Nikitosya13/Tesla-Tek-Altium/IDC_Tester_v1/Gerber/IDC_Tester_v1_DRILL.TXT

M48
;Layer_Color=9474304
;FILE_FORMAT=4:4
METRIC,LZ
;TYPE=PLATED
T1F00S00C0.3000
T2F00S00C1.2000
T3F00S00C3.5000
;TYPE=NON_PLATED
T4F00S00C2.8000
%
T01
X00017Y0007475
X0135575Y0015775
X0134775Y0044225
X0131375Y0041475
X012745Y004035
X01263Y00417
X0122225Y00411
X01223Y003875
X01237Y00381
X01182Y00404
X011688Y0041725
X0112275Y004105
X011155Y003915
X01135Y00381
X01073Y0040325
X0105975Y0041725
X0101475Y0041075
X01012Y003945
X01029Y00381
X0096625Y0040375
X0095475Y0041725
X00947Y00158
X009745Y0015775
X0100125
X0102725Y00158
X01053Y0015775
X010805
X01108
X011355
X01163
X011905
X01218
X012455
X01273
X0130075
X0132825
X009195
X0089225Y00159
X00866Y0015775
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
