Nikitosya13/Tesla-Tek-Altium/IDC_Tester_v1/_check/Bill of Materials-IDC_Tester_v1.xlsx

Sheet: Bill of Materials-IDC_Tester_v1
Designator | MountType | Mount | Part Number | Solder_Amount | Pkg | Layer | Cable/Wire | Mating Terminals | Mating Part | Quantity
C1, C2, C3, C4, C5, C6, C7, C8, C9, C10, C11, C12, C13, C14, C27, C32, C33 | SMD | MOUNT | SMD CAP CER 1UF 25V X5R 0603 (CC0603KRX5R8BB105) | 2 | 0603 | Top |  |  |  | 17
C15, C16, C17, C18, C19, C20, C21, C22, C23, C24, C25, C26 | SMD | MOUNT | SMD CAP CER 1UF 25V X5R 0603 (CC0603KRX5R8BB105) | 2 | 0603 | Bottom |  |  |  | 12
C28, C30 | SMD | MOUNT | CAP CER 0603 0.1uF 16V 10% | 2 | 0603 | Top |  |  |  | 2
C29, C31 | SMD | MOUNT | CAP CER 0603 10uF 16V 10% | 2 | 0603 | Top |  |  |  | 2
DD1 | THM | MOUNT | STM32F103C8T6 (blue pill) | 40 | PBS-40 (STM32 blue pill) | Top |  |  |  | 1
DD2, DD3, DD4, DD5, DD6, DD7, DD8, DD9, DD10, DD11, DD12, DD13 | SMD | MOUNT | 74HC595D,118 | 16 | SOIC-16 | Top |  |  |  | 12
DD14, DD15, DD16, DD17, DD18, DD19, DD20, DD21, DD22, DD23, DD24, DD25 | SMD | MOUNT | SN74HC165DR | 16 | 16-SOIC | Bottom |  |  |  | 12
R1, R3, R5, R7, R9, R11, R13, R15, R17, R19, R21, R23, R25, R27, R29, R31, R33, R35, R37, R39, R41, R43, R45, R47, R49, R51, R53, R55, R57, R59, R61, R63, R65, R67, R69, R71, R73, R75, R77, R79, R81, R83, R85, R87, R89, R91, R93, R95, R97, R99, R101, R103, R105, R107, R109, R111, R113, R115, R117, R119, R121, R123, R125, R127, R129, R131, R133, R135, R137, R139, R141, R143, R145, R147, R149, R151, R153, R155, R157, R159, R161, R163, R165, R167, R169, R171, R173, R175, R177, R179, R181, R183, R185, R187, R189, R191, R313, R315, R317, R319, R325, R327 | SMD | MOUNT | SMD RES 1K OHM 1%±100ppm/°C 0603 (RMCF0603FT1K00) | 2 | 0603 | Top |  |  |  | 102
R2, R6, R10, R14, R18, R22, R26, R30, R34, R38, R42, R46, R50, R54, R58, R62, R66, R70, R74, R78, R82, R86, R90, R94, R98, R102, R106, R110, R114, R118, R122, R126, R130, R134, R138, R142, R146, R150, R154, R158, R162, R166, R170, R174, R178, R182, R186, R190 | SMD | MOUNT | SMD RES 10K OHM 1%±100ppm/°C 0603 (RMCF0603FT10K0) | 2 | 0603 | Bottom |  |  |  | 48
R4, R8, R12, R16, R20, R24, R28, R32, R36, R40, R44, R48, R52, R56, R60, R64, R68, R72, R76, R80, R84, R88, R92, R96, R100, R104, R108, R112, R116, R120, R124, R128, R132, R136, R140, R144, R148, R152, R156, R160, R164, R168, R172, R176, R180, R184, R188, R192, R193, R194, R195, R196, R197, R198, R199, R200, R201, R202, R203, R204, R205, R206, R207, R208, R209, R210, R211, R212, R213, R214, R215, R216, R318, R320, R321, R322, R326, R328 | SMD | MOUNT | SMD RES 10K OHM 1%±100ppm/°C 0603 (RMCF0603FT10K0) | 2 | 0603 | Top |  |  |  | 78
R217, R218, R219, R220, R221, R222, R223, R224, R225, R226, R227, R228, R229, R230, R231, R232, R233, R234, R235, R236, R237, R238, R239, R240, R241, R242, R243, R244, R245, R246, R247, R248, R249, R250, R251, R252, R253, R254, R255, R256, R257, R258, R259, R260, R261, R262, R263, R264, R265, R266, R267, R268, R269, R270, R271, R272, R273, R274, R275, R276, R277, R278, R279, R280, R281, R282, R283, R284, R285, R286, R287, R288, R289, R290, R291, R292, R293, R294, R295, R296, R297, R298, R299, R300, R301, R302, R303, R304, R305, R306, R307, R308, R309, R310, R311, R312 | SMD | MOUNT | SMD RES 100 OHM 1% ±100ppm/°C 0603 (RMCF0603FT100R) | 2 | 0603 | Top |  |  |  | 96
R323, R324 | SMD | DNP | SMD RES 10 OHM 1% ±100ppm/°C 0603 (RMCF0603FT10R) | 2 | 0603 | Top |  |  |  | 2
S1, S2, S3, S4 | SMD | MOUNT | PTS645SM43SMTR92LFS | 4 | Button | Top |  |  |  | 4
U1 | SMD | MOUNT | LM1117DT-3.3/NOPB | 3 | TD03B_N | Top |  |  |  | 1
VD1, VD2, VD3, VD4, VD5, VD6, VD7, VD8, VD9, VD10, VD11, VD12, VD13, VD14, VD15, VD16, VD17, VD18, VD19, VD20, VD21, VD22, VD23, VD24, VD25, VD26, VD27, VD28, VD29, VD30, VD31, VD32, VD33, VD34, VD35, VD36, VD37, VD38, VD39, VD40, VD41, VD42, VD43, VD44, VD45, VD46, VD47, VD48, VD49, VD50, VD51, VD52, VD53, VD54, VD55, VD56, VD57, VD58, VD59, VD60, VD61, VD62, VD63, VD64, VD65, VD66, VD67, VD68, VD69, VD70, VD71, VD72, VD73, VD74, VD75, VD76, VD77, VD78, VD79, VD80, VD81, VD82, VD83, VD84, VD85, VD86, VD87, VD88, VD89, VD90, VD91, VD92, VD93, VD94, VD95, VD96, VD97 | SMD | MOUNT | APG1608ZGCK | 2 | 0603 | Top |  |  |  | 97
VD98 | SMD | MOUNT | APT1608SURCK | 2 | 0603 | Top |  |  |  | 1
VT1, VT3, VT5, VT7, VT9, VT11, VT13, VT15, VT17, VT19, VT21, VT23, VT25, VT27, VT29, VT31, VT33, VT35, VT37, VT39, VT41, VT43, VT45, VT47, VT49, VT51, VT53, VT55, VT57, VT59, VT61, VT63, VT65, VT67, VT69, VT71, VT73, VT75, VT77, VT79, VT81, VT83, VT85, VT87, VT89, VT91, VT93, VT95 | SMD | MOUNT | BSS138 | 3 | SOT-23 | Bottom |  |  |  | 48
VT2, VT4, VT6, VT8, VT10, VT12, VT14, VT16, VT18, VT20, VT22, VT24, VT26, VT28, VT30, VT32, VT34, VT36, VT38, VT40, VT42, VT44, VT46, VT48, VT50, VT52, VT54, VT56, VT58, VT60, VT62, VT64, VT66, VT68, VT70, VT72, VT74, VT76, VT78, VT80, VT82, VT84, VT86, VT88, VT90, VT92, VT94, VT96 | SMD | MOUNT | BSS138 | 3 | SOT-23 | Top |  |  |  | 48
X1, X2, X4, X5 | THM | MOUNT | DS1021-2x20 | 40 | PLD-40 | Top |  |  |  | 4
X3, X6 | THM | MOUNT | DS1021-2x8 | 16 | PLD-16 | Top |  |  |  | 2
X7 | THM | MOUNT | LCD1602I2C (green light) | 4 | board (connector) | Top |  |  |  | 1

Sheet: Перечень_элементов
Позиционное обозначение | Наименование | Корпус | Кол-во
Резисторы
R1, R3, R5, R7, R9, R11, R13, R15, R17, R19, R21, R23, R25, R27, R29, R31, R33, R35, R37, R39, R41, R43, R45, R47, R49, R51, R53, R55, R57, R59, R61, R63, R65, R67, R69, R71, R73, R75, R77, R79, R81, R83, R85, R87, R89, R91, R93, R95, R97, R99, R101, R103, R105, R107, R109, R111, R113, R115, R117, R119, R121, R123, R125, R127, R129, R131, R133, R135, R137, R139, R141, R143, R145, R147, R149, R151, R153, R155, R157, R159, R161, R163, R165, R167, R169, R171, R173, R175, R177, R179, R181, R183, R185, R187, R189, R191, R313, R315, R317, R319, R325, R327 | SMD RES 1K OHM 1%±100ppm/°C 0603 (RMCF0603FT1K00) | 0603 | 102
R2, R6, R10, R14, R18, R22, R26, R30, R34, R38, R42, R46, R50, R54, R58, R62, R66, R70, R74, R78, R82, R86, R90, R94, R98, R102, R106, R110, R114, R118, R122, R126, R130, R134, R138, R142, R146, R150, R154, R158, R162, R166, R170, R174, R178, R182, R186, R190, R4, R8, R12, R16, R20, R24, R28, R32, R36, R40, R44, R48, R52, R56, R60, R64, R68, R72, R76, R80, R84, R88, R92, R96, R100, R104, R108, R112, R116, R120, R124, R128, R132, R136, R140, R144, R148, R152, R156, R160, R164, R168, R172, R176, R180, R184, R188, R192, R193, R194, R195, R196, R197, R198, R199, R200, R201, R202, R203, R204, R205, R206, R207, R208, R209, R210, R211, R212, R213, R214, R215, R216, R318, R320, R321, R322, R326, R328 | SMD RES 10K OHM 1%±100ppm/°C 0603 (RMCF0603FT10K0) | 0603 | 126
R217, R218, R219, R220, R221, R222, R223, R224, R225, R226, R227, R228, R229, R230, R231, R232, R233, R234, R235, R236, R237, R238, R239, R240, R241, R242, R243, R244, R245, R246, R247, R248, R249, R250, R251, R252, R253, R254, R255, R256, R257, R258, R259, R260, R261, R262, R263, R264, R265, R266, R267, R268, R269, R270, R271, R272, R273, R274, R275, R276, R277, R278, R279, R280, R281, R282, R283, R284, R285, R286, R287, R288, R289, R290, R291, R292, R293, R294, R295, R296, R297, R298, R299, R300, R301, R302, R303, R304, R305, R306, R307, R308, R309, R310, R311, R312 | SMD RES 100 OHM 1% ±100ppm/°C 0603 (RMCF0603FT100R) | 0603 | 96
R323, R324 | SMD RES 10 OHM 1% ±100ppm/°C 0603 (RMCF0603FT10R) | 0603 | 2
Конденсаторы
C1, C2, C3, C4, C5, C6, C7, C8, C9, C10, C11, C12, C13, C14, C27, C32, C33, C15, C16, C17, C18, C19, C20, C21, C22, C23, C24, C25, C26 | SMD CAP CER 1UF 25V X5R 0603 (CC0603KRX5R8BB105) | 0603 | 29
C28, C30 | CAP CER 0603 0.1uF 16V 10% | 0603 | 2
C29, C31 | CAP CER 0603 10uF 16V 10% | 0603 | 2
Диоды / Транзисторы
VD1, VD2, VD3, VD4, VD5, VD6, VD7, VD8, VD9, VD10, VD11, VD12, VD13, VD14, VD15, VD16, VD17, VD18, VD19, VD20, VD21, VD22, VD23, VD24, VD25, VD26, VD27, VD28, VD29, VD30, VD31, VD32, VD33, VD34, VD35, VD36, VD37, VD38, VD39, VD40, VD41, VD42, VD43, VD44, VD45, VD46, VD47, VD48, VD49, VD50, VD51, VD52, VD53, VD54, VD55, VD56, VD57, VD58, VD59, VD60, VD61, VD62, VD63, VD64, VD65, VD66, VD67, VD68, VD69, VD70, VD71, VD72, VD73, VD74, VD75, VD76, VD77, VD78, VD79, VD80, VD81, VD82, VD83, VD84, VD85, VD86, VD87, VD88, VD89, VD90, VD91, VD92, VD93, VD94, VD95, VD96, VD97 | APG1608ZGCK | 0603 | 97
VD98 | APT1608SURCK | 0603 | 1
VT1, VT3, VT5, VT7, VT9, VT11, VT13, VT15, VT17, VT19, VT21, VT23, VT25, VT27, VT29, VT31, VT33, VT35, VT37, VT39, VT41, VT43, VT45, VT47, VT49, VT51, VT53, VT55, VT57, VT59, VT61, VT63, VT65, VT67, VT69, VT71, VT73, VT75, VT77, VT79, VT81, VT83, VT85, VT87, VT89, VT91, VT93, VT95, VT2, VT4, VT6, VT8, VT10, VT12, VT14, VT16, VT18, VT20, VT22, VT24, VT26, VT28, VT30, VT32, VT34, VT36, VT38, VT40, VT42, VT44, VT46, VT48, VT50, VT52, VT54, VT56, VT58, VT60, VT62, VT64, VT66, VT68, VT70, VT72, VT74, VT76, VT78, VT80, VT82, VT84, VT86, VT88, VT90, VT92, VT94, VT96 | BSS138 | SOT-23 | 96
Микросхемы
DD1 | STM32F103C8T6 (blue pill) | PBS-40 (STM32 blue pill) | 1
DD2, DD3, DD4, DD5, DD6, DD7, DD8, DD9, DD10, DD11, DD12, DD13 | 74HC595D,118 | SOIC-16 | 12
DD14, DD15, DD16, DD17, DD18, DD19, DD20, DD21, DD22, DD23, DD24, DD25 | SN74HC165DR | 16-SOIC | 12
U1 | LM1117DT-3.3/NOPB | TD03B_N | 1
Переключатели/кнопки/ключи
S1, S2, S3, S4 | PTS645SM43SMTR92LFS | Button | 4
Разъемы
X1, X2, X4, X5 | DS1021-2x20 | PLD-40 | 4
X3, X6 | DS1021-2x8 | PLD-16 | 2
X7 | LCD1602I2C (green light) | board (connector) | 1

Sheet: Монтажная_Спецификация
Перечень монтируемых элементов Bill of Materials-IDC_Tester_v1
Позиционное обозначение | Наименование | Корпус | Кол-во | Кол-во паек / поз. | Общее кол-во паек | Тип монтажа
Сторона TOP
C1, C2, C3, C4, C5, C6, C7, C8, C9, C10, C11, C12, C13, C14, C27, C32, C33 | SMD CAP CER 1UF 25V X5R 0603 (CC0603KRX5R8BB105) | 0603 | 17 | 2 | 34 | SMD
C28, C30 | CAP CER 0603 0.1uF 16V 10% | 0603 | 2 | 2 | 4 | SMD
C29, C31 | CAP CER 0603 10uF 16V 10% | 0603 | 2 | 2 | 4 | SMD
DD2, DD3, DD4, DD5, DD6, DD7, DD8, DD9, DD10, DD11, DD12, DD13 | 74HC595D,118 | SOIC-16 | 12 | 16 | 192 | SMD
R1, R3, R5, R7, R9, R11, R13, R15, R17, R19, R21, R23, R25, R27, R29, R31, R33, R35, R37, R39, R41, R43, R45, R47, R49, R51, R53, R55, R57, R59, R61, R63, R65, R67, R69, R71, R73, R75, R77, R79, R81, R83, R85, R87, R89, R91, R93, R95, R97, R99, R101, R103, R105, R107, R109, R111, R113, R115, R117, R119, R121, R123, R125, R127, R129, R131, R133, R135, R137, R139, R141, R143, R145, R147, R149, R151, R153, R155, R157, R159, R161, R163, R165, R167, R169, R171, R173, R175, R177, R179, R181, R183, R185, R187, R189, R191, R313, R315, R317, R319, R325, R327 | SMD RES 1K OHM 1%±100ppm/°C 0603 (RMCF0603FT1K00) | 0603 | 102 | 2 | 204 | SMD
R217, R218, R219, R220, R221, R222, R223, R224, R225, R226, R227, R228, R229, R230, R231, R232, R233, R234, R235, R236, R237, R238, R239, R240, R241, R242, R243, R244, R245, R246, R247, R248, R249, R250, R251, R252, R253, R254, R255, R256, R257, R258, R259, R260, R261, R262, R263, R264, R265, R266, R267, R268, R269, R270, R271, R272, R273, R274, R275, R276, R277, R278, R279, R280, R281, R282, R283, R284, R285, R286, R287, R288, R289, R290, R291, R292, R293, R294, R295, R296, R297, R298, R299, R300, R301, R302, R303, R304, R305, R306, R307, R308, R309, R310, R311, R312 | SMD RES 100 OHM 1% ±100ppm/°C 0603 (RMCF0603FT100R) | 0603 | 96 | 2 | 192 | SMD
R4, R8, R12, R16, R20, R24, R28, R32, R36, R40, R44, R48, R52, R56, R60, R64, R68, R72, R76, R80, R84, R88, R92, R96, R100, R104, R108, R112, R116, R120, R124, R128, R132, R136, R140, R144, R148, R152, R156, R160, R164, R168, R172, R176, R180, R184, R188, R192, R193, R194, R195, R196, R197, R198, R199, R200, R201, R202, R203, R204, R205, R206, R207, R208, R209, R210, R211, R212, R213, R214, R215, R216, R318, R320, R321, R322, R326, R328 | SMD RES 10K OHM 1%±100ppm/°C 0603 (RMCF0603FT10K0) | 0603 | 78 | 2 | 156 | SMD
S1, S2, S3, S4 | PTS645SM43SMTR92LFS | Button | 4 | 4 | 16 | SMD
U1 | LM1117DT-3.3/NOPB | TD03B_N | 1 | 3 | 3 | SMD
VD1, VD2, VD3, VD4, VD5, VD6, VD7, VD8, VD9, VD10, VD11, VD12, VD13, VD14, VD15, VD16, VD17, VD18, VD19, VD20, VD21, VD22, VD23, VD24, VD25, VD26, VD27, VD28, VD29, VD30, VD31, VD32, VD33, VD34, VD35, VD36, VD37, VD38, VD39, VD40, VD41, VD42, VD43, VD44, VD45, VD46, VD47, VD48, VD49, VD50, VD51, VD52, VD53, VD54, VD55, VD56, VD57, VD58, VD59, VD60, VD61, VD62, VD63, VD64, VD65, VD66, VD67, VD68, VD69, VD70, VD71, VD72, VD73, VD74, VD75, VD76, VD77, VD78, VD79, VD80, VD81, VD82, VD83, VD84, VD85, VD86, VD87, VD88, VD89, VD90, VD91, VD92, VD93, VD94, VD95, VD96, VD97 | APG1608ZGCK | 0603 | 97 | 2 | 194 | SMD
VD98 | APT1608SURCK | 0603 | 1 | 2 | 2 | SMD
VT2, VT4, VT6, VT8, VT10, VT12, VT14, VT16, VT18, VT20, VT22, VT24, VT26, VT28, VT30, VT32, VT34, VT36, VT38, VT40, VT42, VT44, VT46, VT48, VT50, VT52, VT54, VT56, VT58, VT60, VT62, VT64, VT66, VT68, VT70, VT72, VT74, VT76, VT78, VT80, VT82, VT84, VT86, VT88, VT90, VT92, VT94, VT96 | BSS138 | SOT-23 | 48 | 3 | 144 | SMD
DD1 | STM32F103C8T6 (blue pill) | PBS-40 (STM32 blue pill) | 1 | 40 | 40 | THM
X1, X2, X4, X5 | DS1021-2x20 | PLD-40 | 4 | 40 | 160 | THM
X3, X6 | DS1021-2x8 | PLD-16 | 2 | 16 | 32 | THM
X7 | LCD1602I2C (green light) | board (connector) | 1 | 4 | 4 | THM
Сторона BOT
C15, C16, C17, C18, C19, C20, C21, C22, C23, C24, C25, C26 | SMD CAP CER 1UF 25V X5R 0603 (CC0603KRX5R8BB105) | 0603 | 12 | 2 | 24 | SMD
DD14, DD15, DD16, DD17, DD18, DD19, DD20, DD21, DD22, DD23, DD24, DD25 | SN74HC165DR | 16-SOIC | 12 | 16 | 192 | SMD
R2, R6, R10, R14, R18, R22, R26, R30, R34, R38, R42, R46, R50, R54, R58, R62, R66, R70, R74, R78, R82, R86, R90, R94, R98, R102, R106, R110, R114, R118, R122, R126, R130, R134, R138, R142, R146, R150, R154, R158, R162, R166, R170, R174, R178, R182, R186, R190 | SMD RES 10K OHM 1%±100ppm/°C 0603 (RMCF0603FT10K0) | 0603 | 48 | 2 | 96 | SMD
VT1, VT3, VT5, VT7, VT9, VT11, VT13, VT15, VT17, VT19, VT21, VT23, VT25, VT27, VT29, VT31, VT33, VT35, VT37, VT39, VT41, VT43, VT45, VT47, VT49, VT51, VT53, VT55, VT57, VT59, VT61, VT63, VT65, VT67, VT69, VT71, VT73, VT75, VT77, VT79, VT81, VT83, VT85, VT87, VT89, VT91, VT93, VT95 | BSS138 | SOT-23 | 48 | 3 | 144 | SMD
Количество паек на устройство
Сторона TOP
Количество паек SMD |  |  |  |  |  | 1145
Количество паек THM |  |  |  |  |  | 236
Общее количество паек на стороне TOP |  |  |  |  |  | 1381
Количество компонентов SMD |  |  |  |  |  | 460
Количество компонентов THM |  |  |  |  |  | 8
Общее количество компонентов на стороне TOP |  |  |  |  |  | 468
Сторона BOT
Количество паек SMD |  |  |  |  |  | 456
Количество паек THM |  |  |  |  |  | 0
Общее количество паек на стороне BOT |  |  |  |  |  | 456
Количество компонентов SMD |  |  |  |  |  | 120
Количество компонентов THM |  |  |  |  |  | 0
Общее количество компонентов на стороне BOT |  |  |  |  |  | 120
Итог
Всего паек SMD |  |  |  |  |  | 1601
Всего паек THM |  |  |  |  |  | 236
Всего компонентов SMD |  |  |  |  |  | 580
Всего компонентов THM |  |  |  |  |  | 8
Перечень немонтируемых элементов Bill of Materials-IDC_Tester_v1
Позиционное обозначение | Наименование | Корпус | Кол-во | Кол-во паек / поз. | Общее кол-во паек | Тип монтажа
Сторона TOP
R323, R324 | SMD RES 10 OHM 1% ±100ppm/°C 0603 (RMCF0603FT10R) | 0603 | 2 | 2 | 4 | SMD
Сторона BOT

Sheet: К_заказу
Наименование | Корпус | Кол-во общее | Кол-во DNP
74HC595D,118 | SOIC-16 | 12
APG1608ZGCK | 0603 | 97
APT1608SURCK | 0603 | 1
BSS138 | SOT-23 | 96
CAP CER 0603 0.1uF 16V 10% | 0603 | 2
CAP CER 0603 10uF 16V 10% | 0603 | 2
DS1021-2x20 | PLD-40 | 4
DS1021-2x8 | PLD-16 | 2
LCD1602I2C (green light) | board (connector) | 1
LM1117DT-3.3/NOPB | TD03B_N | 1
PTS645SM43SMTR92LFS | Button | 4
SMD CAP CER 1UF 25V X5R 0603 (CC0603KRX5R8BB105) | 0603 | 29
SMD RES 10 OHM 1% ±100ppm/°C 0603 (RMCF0603FT10R) | 0603 | 2 | 2
SMD RES 100 OHM 1% ±100ppm/°C 0603 (RMCF0603FT100R) | 0603 | 96
SMD RES 10K OHM 1%±100ppm/°C 0603 (RMCF0603FT10K0) | 0603 | 126
SMD RES 1K OHM 1%±100ppm/°C 0603 (RMCF0603FT1K00) | 0603 | 102
SN74HC165DR | 16-SOIC | 12
STM32F103C8T6 (blue pill) | PBS-40 (STM32 blue pill) | 1
