Nikitosya13/Tesla-Tek-Altium/IDC_Tester_v1/_3d/IDC_Tester_v1.step

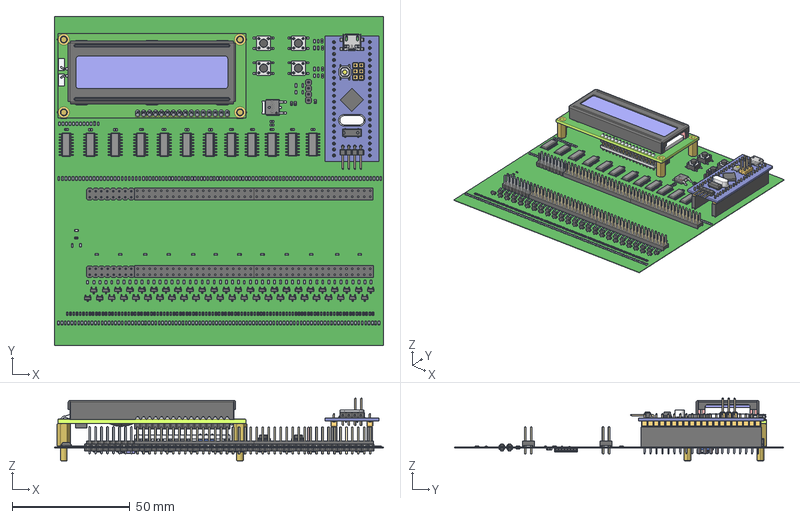
[picture p1: CAD file, 2024-02-29]
IDC_Tester_v1/_3d/IDC_Tester_v1.step
140.0 x 140.0 x 26.8 mm
crg0603f10r x 326
YAG_CC0603_YAG x 33
User_Library-TO-252-3
pcbboard
16pin_header__
lcd_window
backlight
conductor x 2
liquid_crystal_grabcad_i2s
smt_resistor222 x 10
smt_resistor101 x 2
i2C_board
jumper__
pcf8574p
bent_header x 6
led
ssot3
trimpot_3662
smt_cap
M3_M_TO_F_10MM_STANDOFF x 4
PLS-1 x 8
User_Library-PLD-16 x 2
User_Library-PLD-40 x 4
SOT-23-3 x 96
APG1608
LED_0603_Base_GREEN x 97
BODY-SO x 24
LEAD-SO x 384
PIN1-ID x 24
User_Library-PBS_(DS1023)_1line_connectors_h=5_0_8_5mm_step_2_54mm-1 x 2
Oscillator_HC-49/S_v1
STM32F103C8T6_BluePill_Board_v6
Oscillator_MC-306_v3
STM32_LQFP48_v3
Tactile_SMD_5x5mm_v1
micro_usb_socket_v1
Header_L4_10x4.8_v6
Header_Male_2x3x11.6_v2
Header_Male_1x20x11.6_v2 x 2
