Nikitosya13/Tesla-Tek-Altium/IDC_Tester_v1/_docs/IDC_Tester_v1_SCHEMATIC.PDF

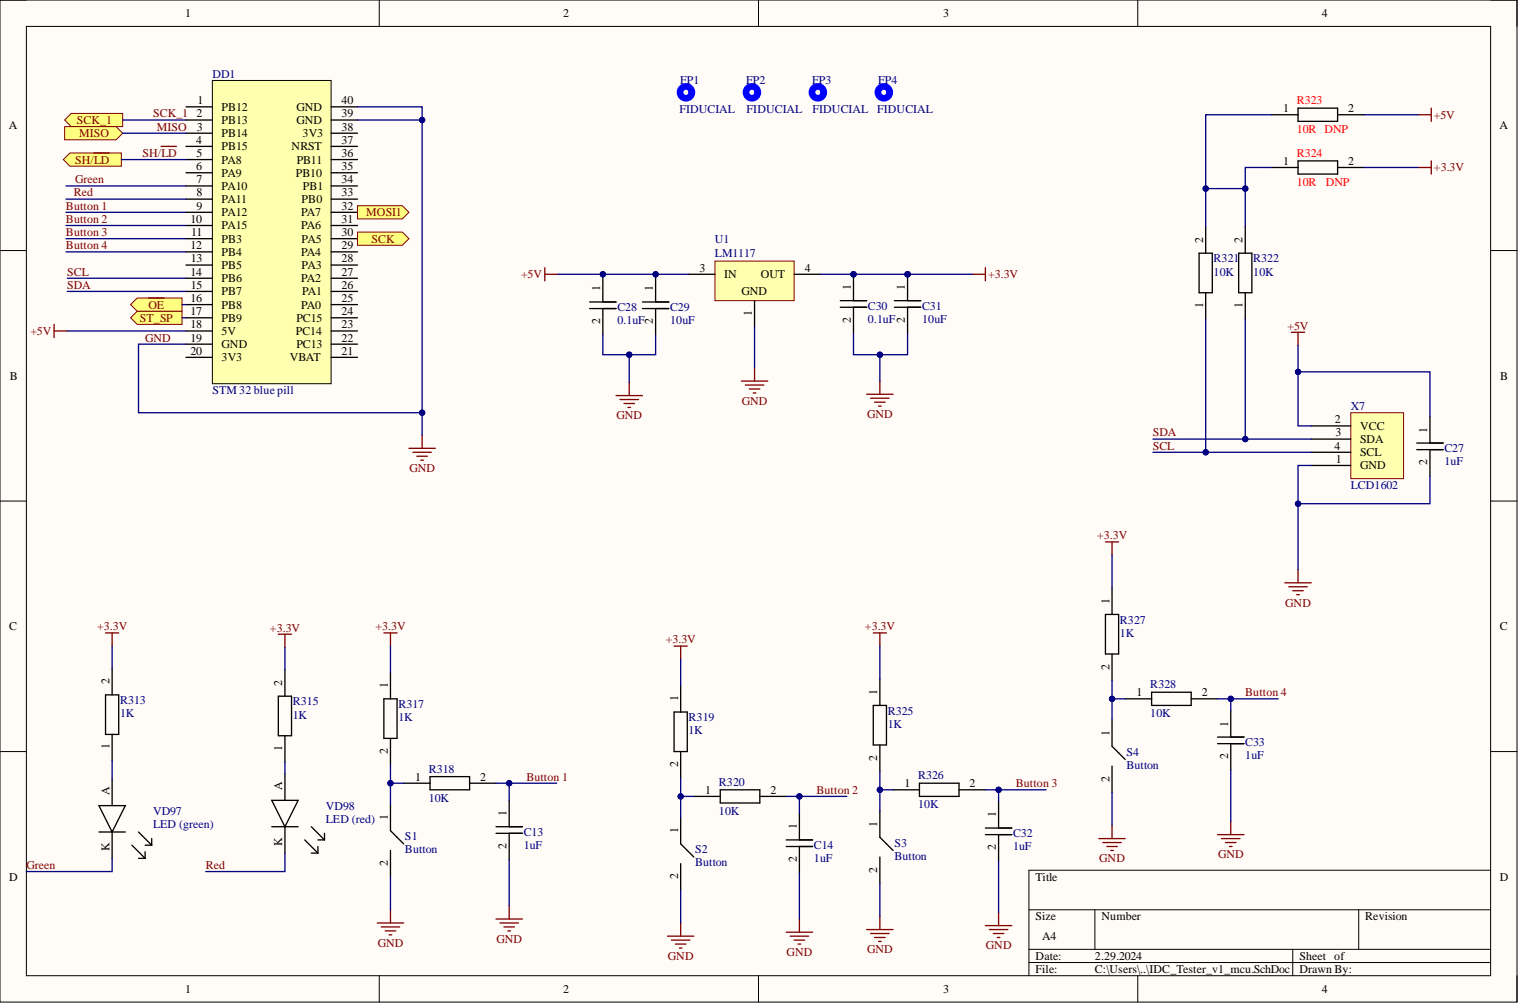
[picture p2: page 1]

X7
VCC 2

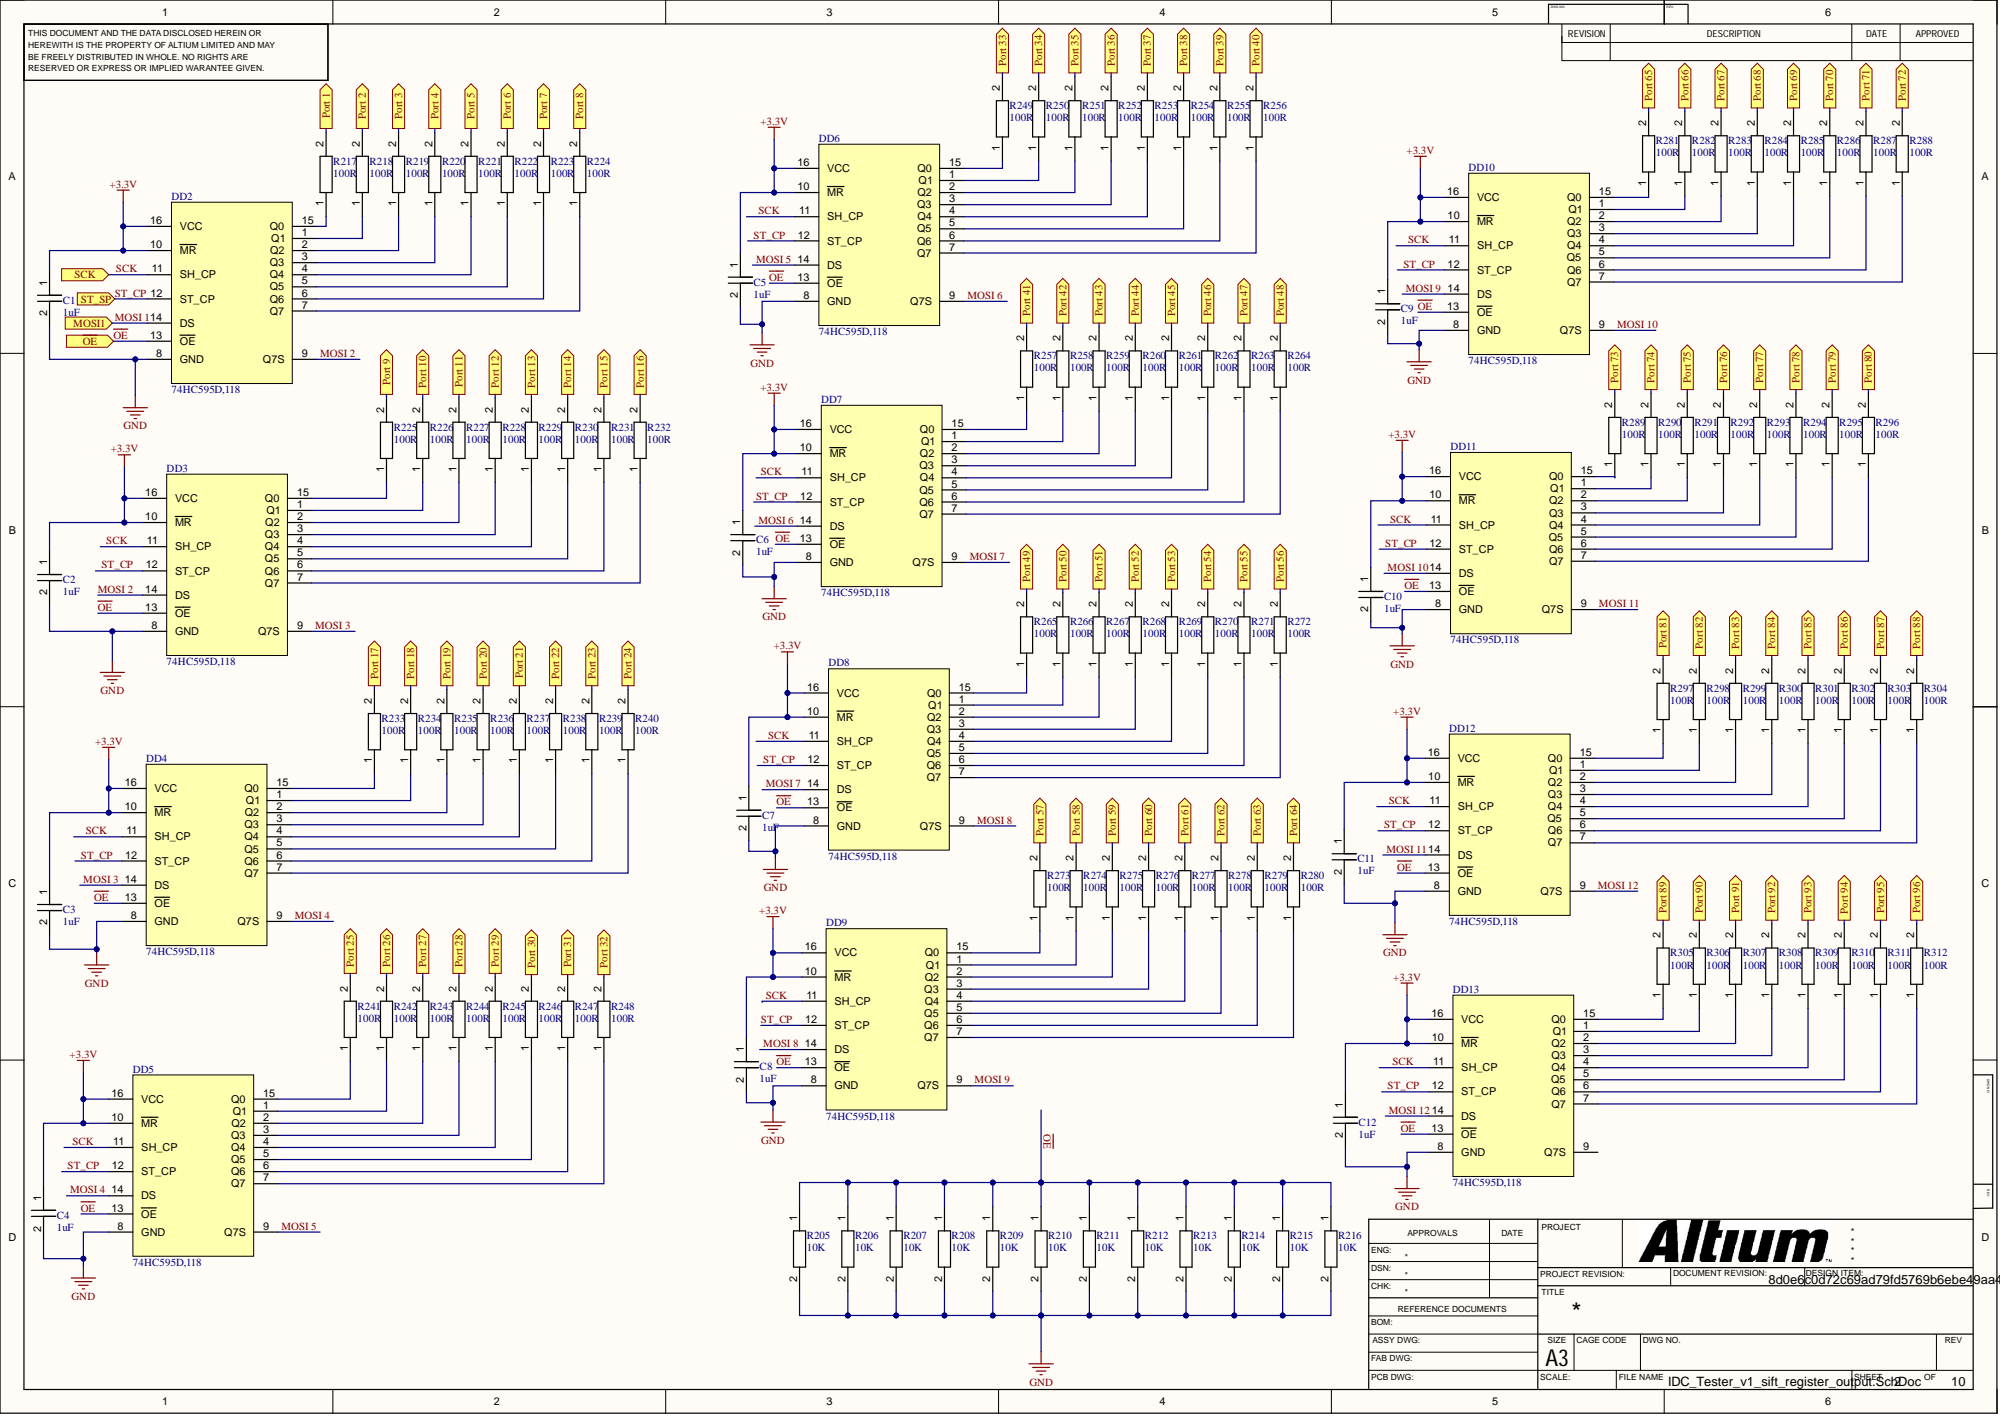
[picture p3: page 2]

DWG NO: | REV:

THIS DOCUMENT AND THE DATA DISCLOSED HEREIN OR HEREWITH IS THE PROPERTY OF ALTIUM LIMITED AND MAY BE FREELY DISTRIBUTED IN WHOLE. NO RIGHTS ARE RESERVED OR EXPRESS OR IMPLIED WARANTEE GIVEN. | | REVISION | DESCRIPTION | DATE | APPROVED

DATE | PROJECT | * * APPROVALS * *

ENG: *

DSN: *

CHK:

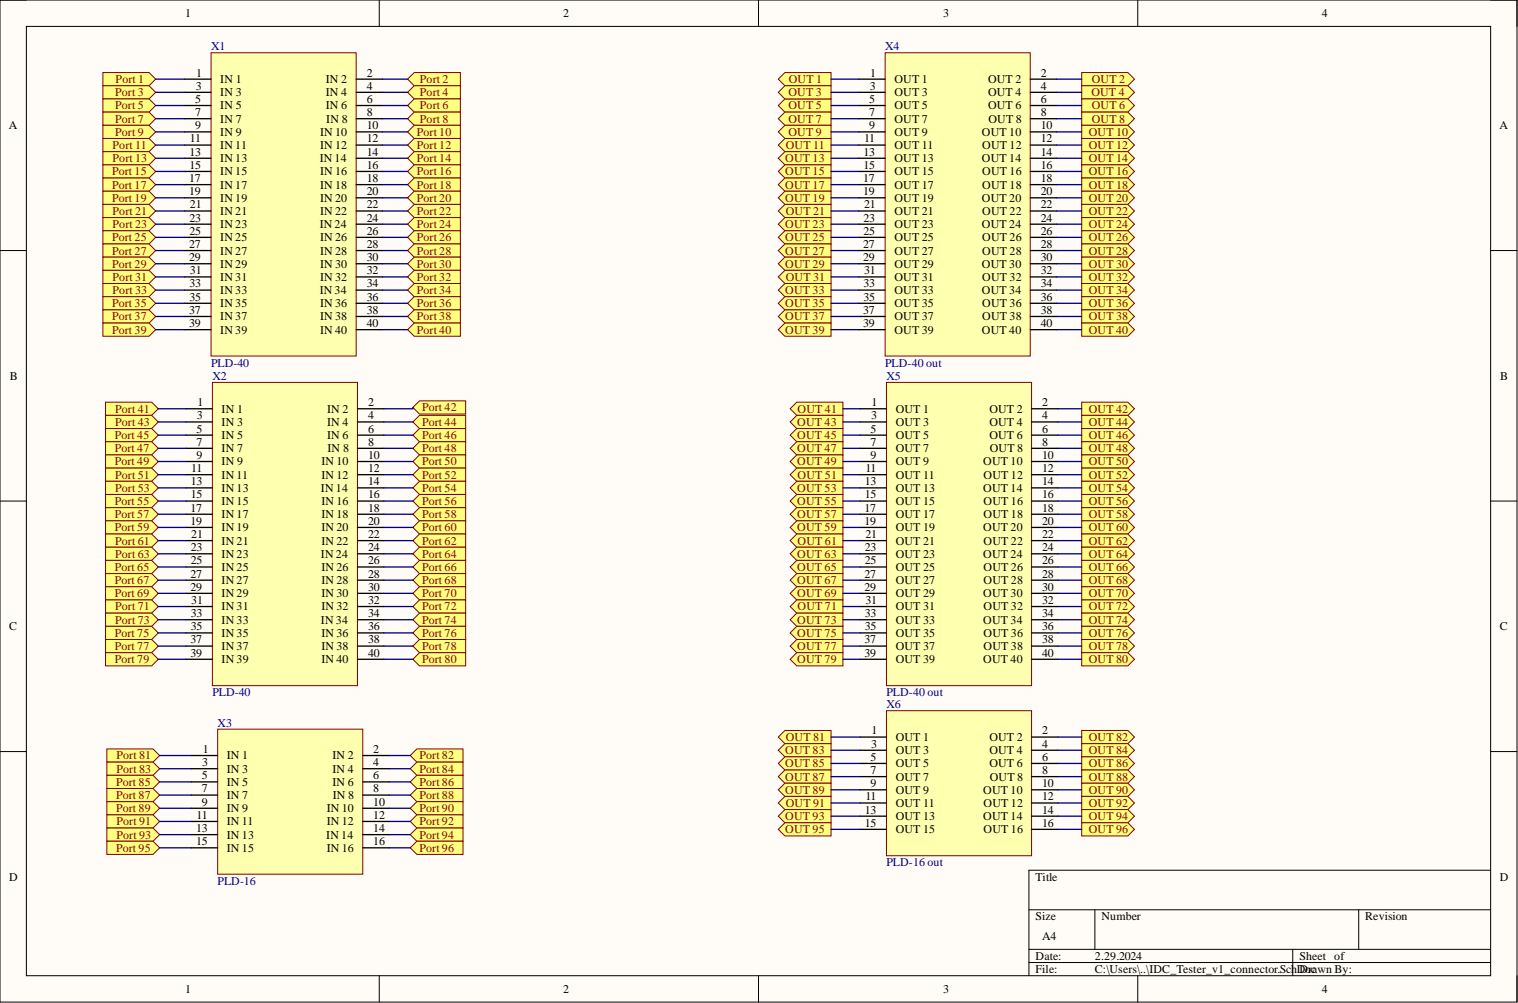
[picture p4: page 3]

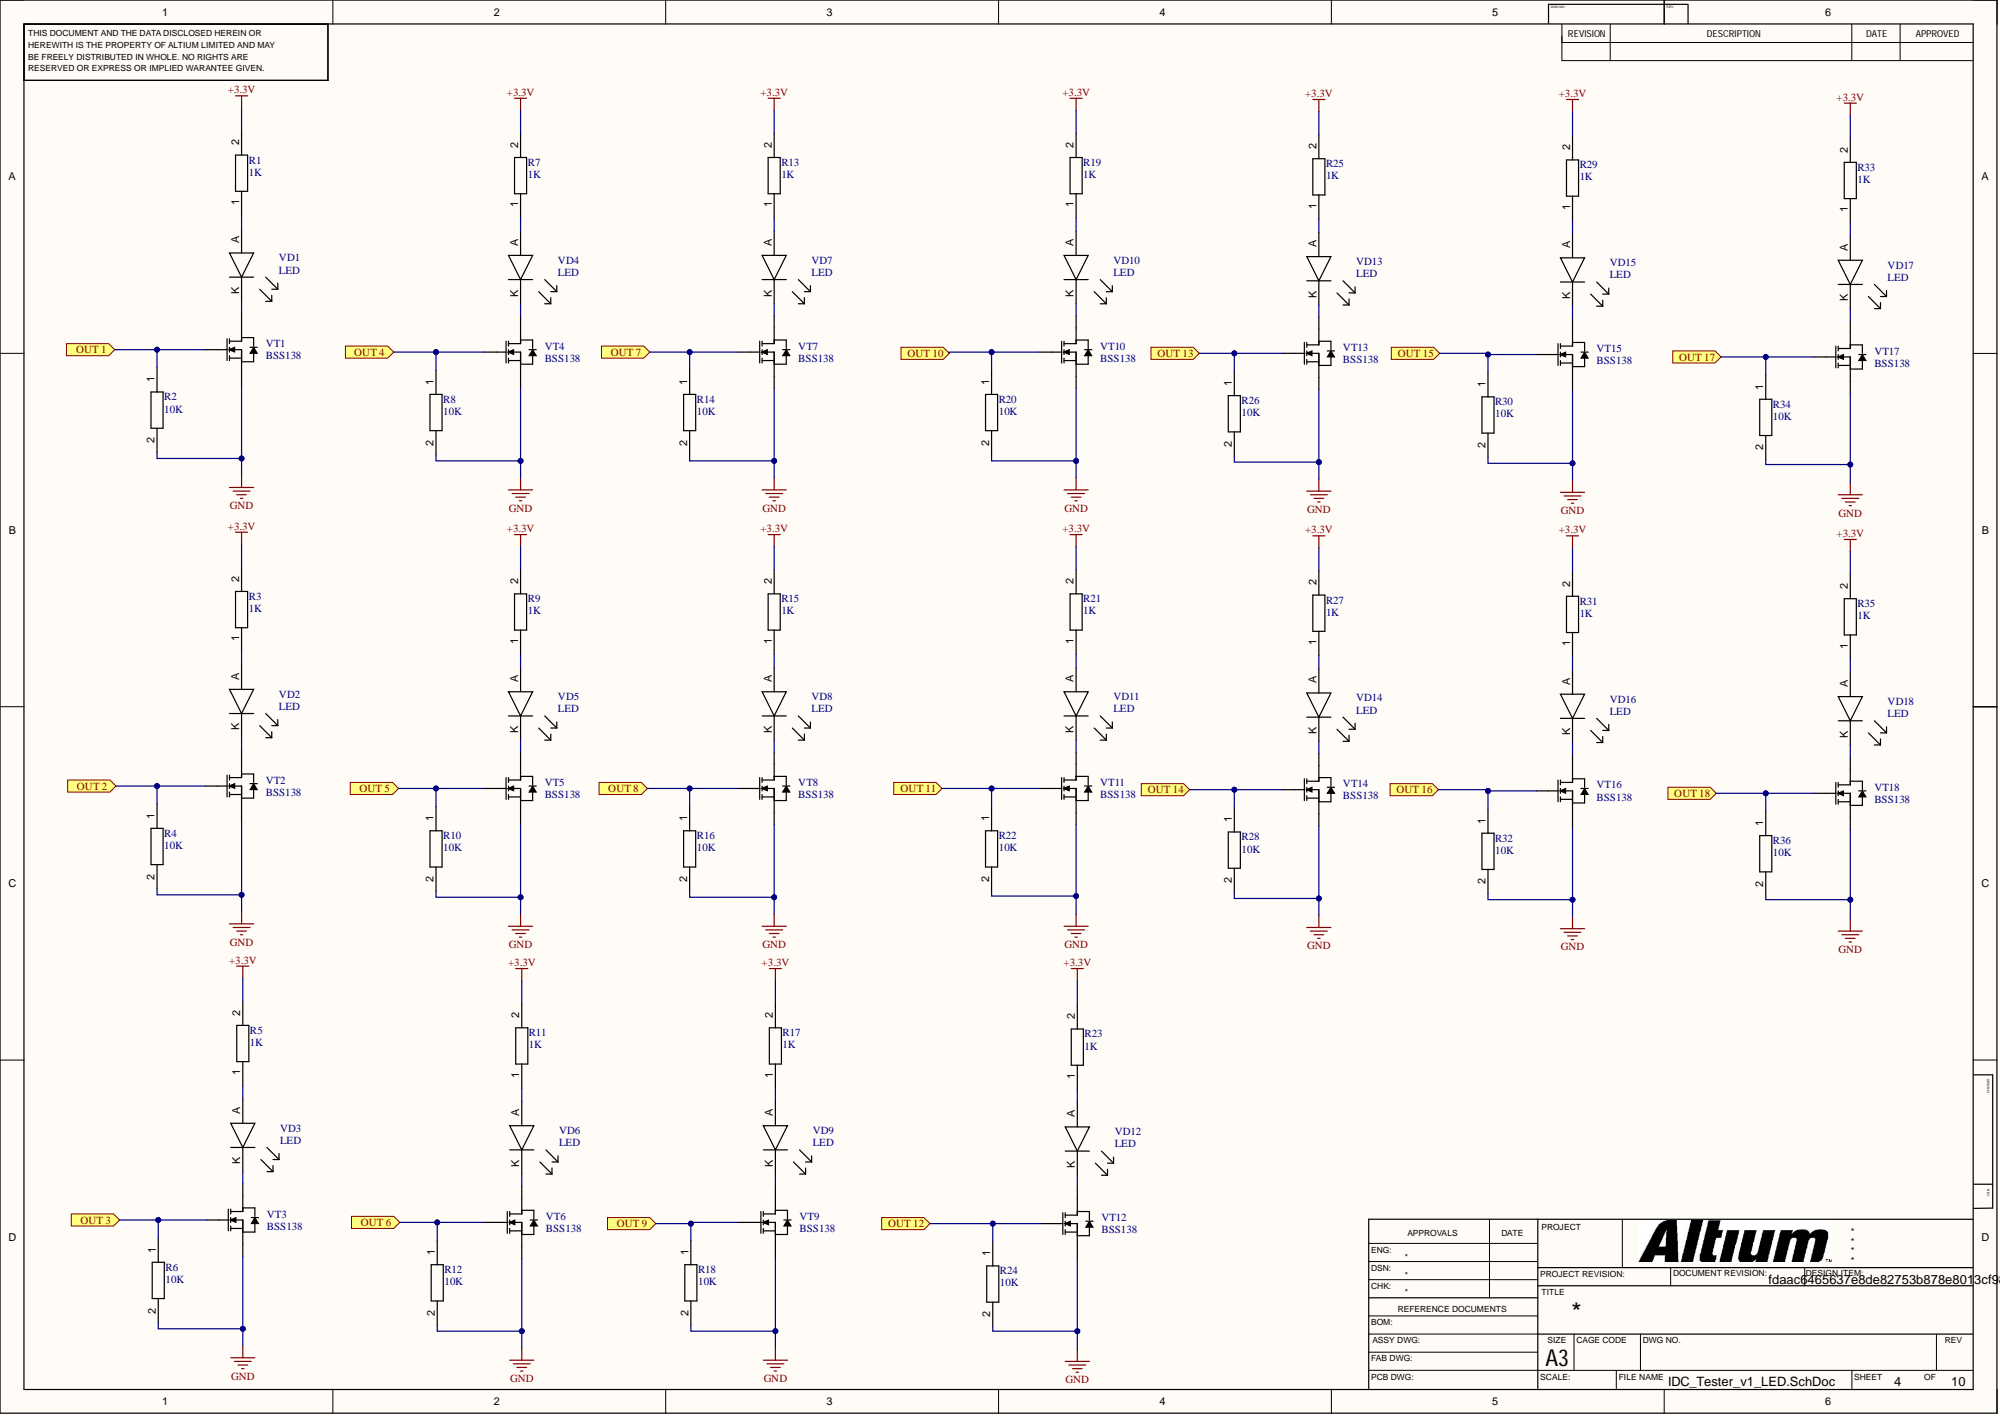
[picture p5: page 4]

THIS DOCUMENT AND THE DA TA DISCL OSED HEREIN O R HEREWITH IS THE PROPERTY OF ALTIUM LIMITED AND M AY BE FREELY DISTRIBUTED IN WHO LE. NO RIGHTS ARE | +3.3 V +3.3 V +3.3 V | REVISI ON | DESCRIPTI O N | DATE | APPROVED

DATE | PRO JECT | **** APPROVALS

ENG :
** DSN:

CHK:

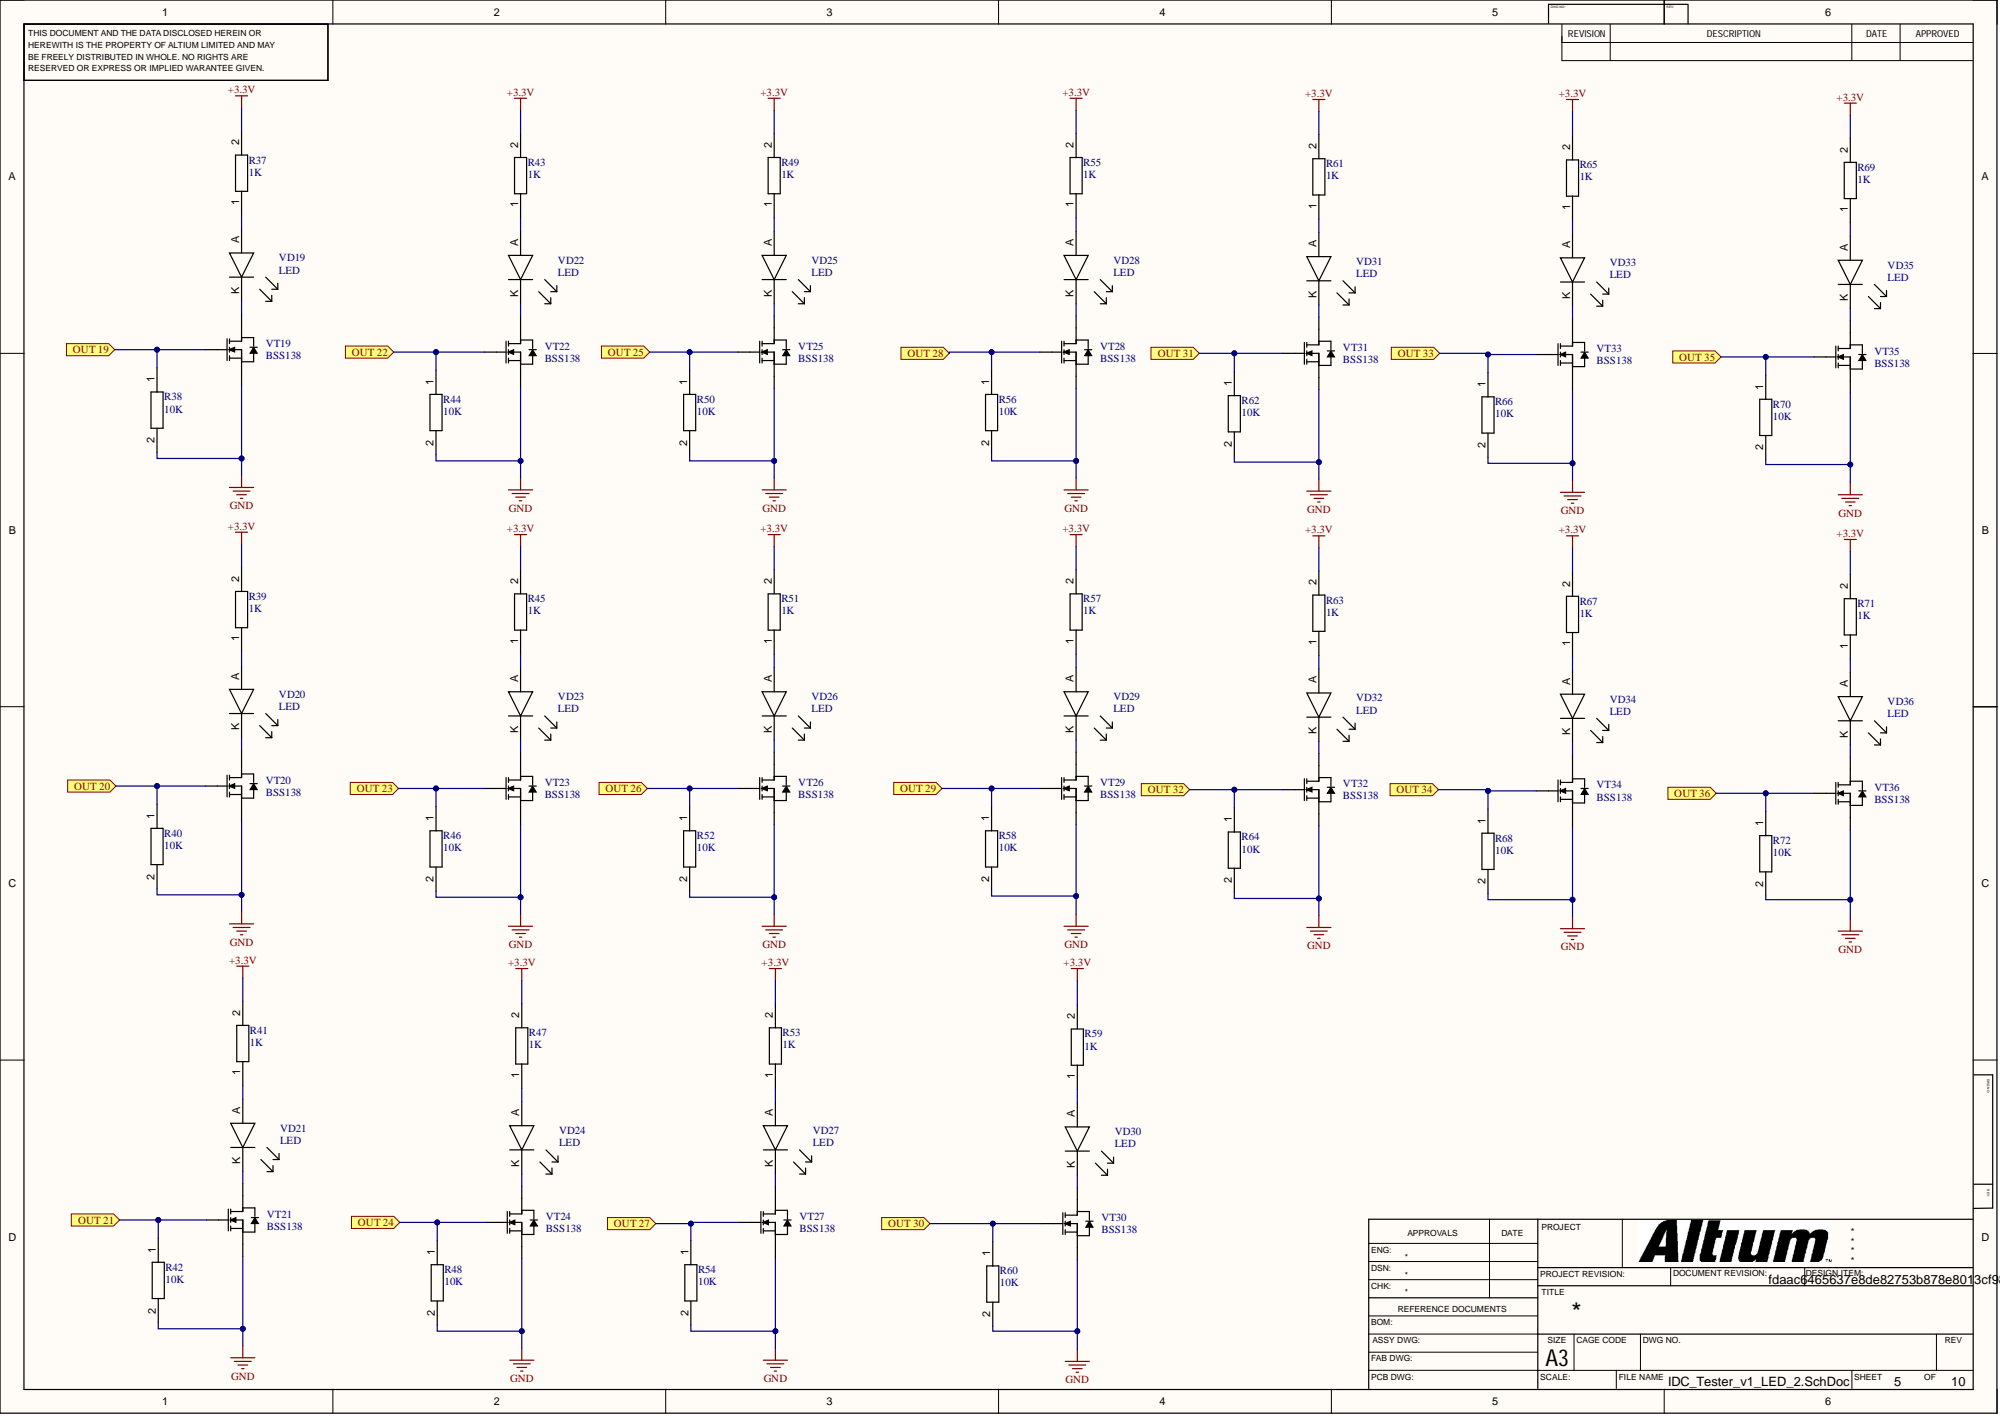
[picture p6: page 5]

DATE | PROJECT | * * APPROVALS * *

ENG: *

DSN: *

CHK:

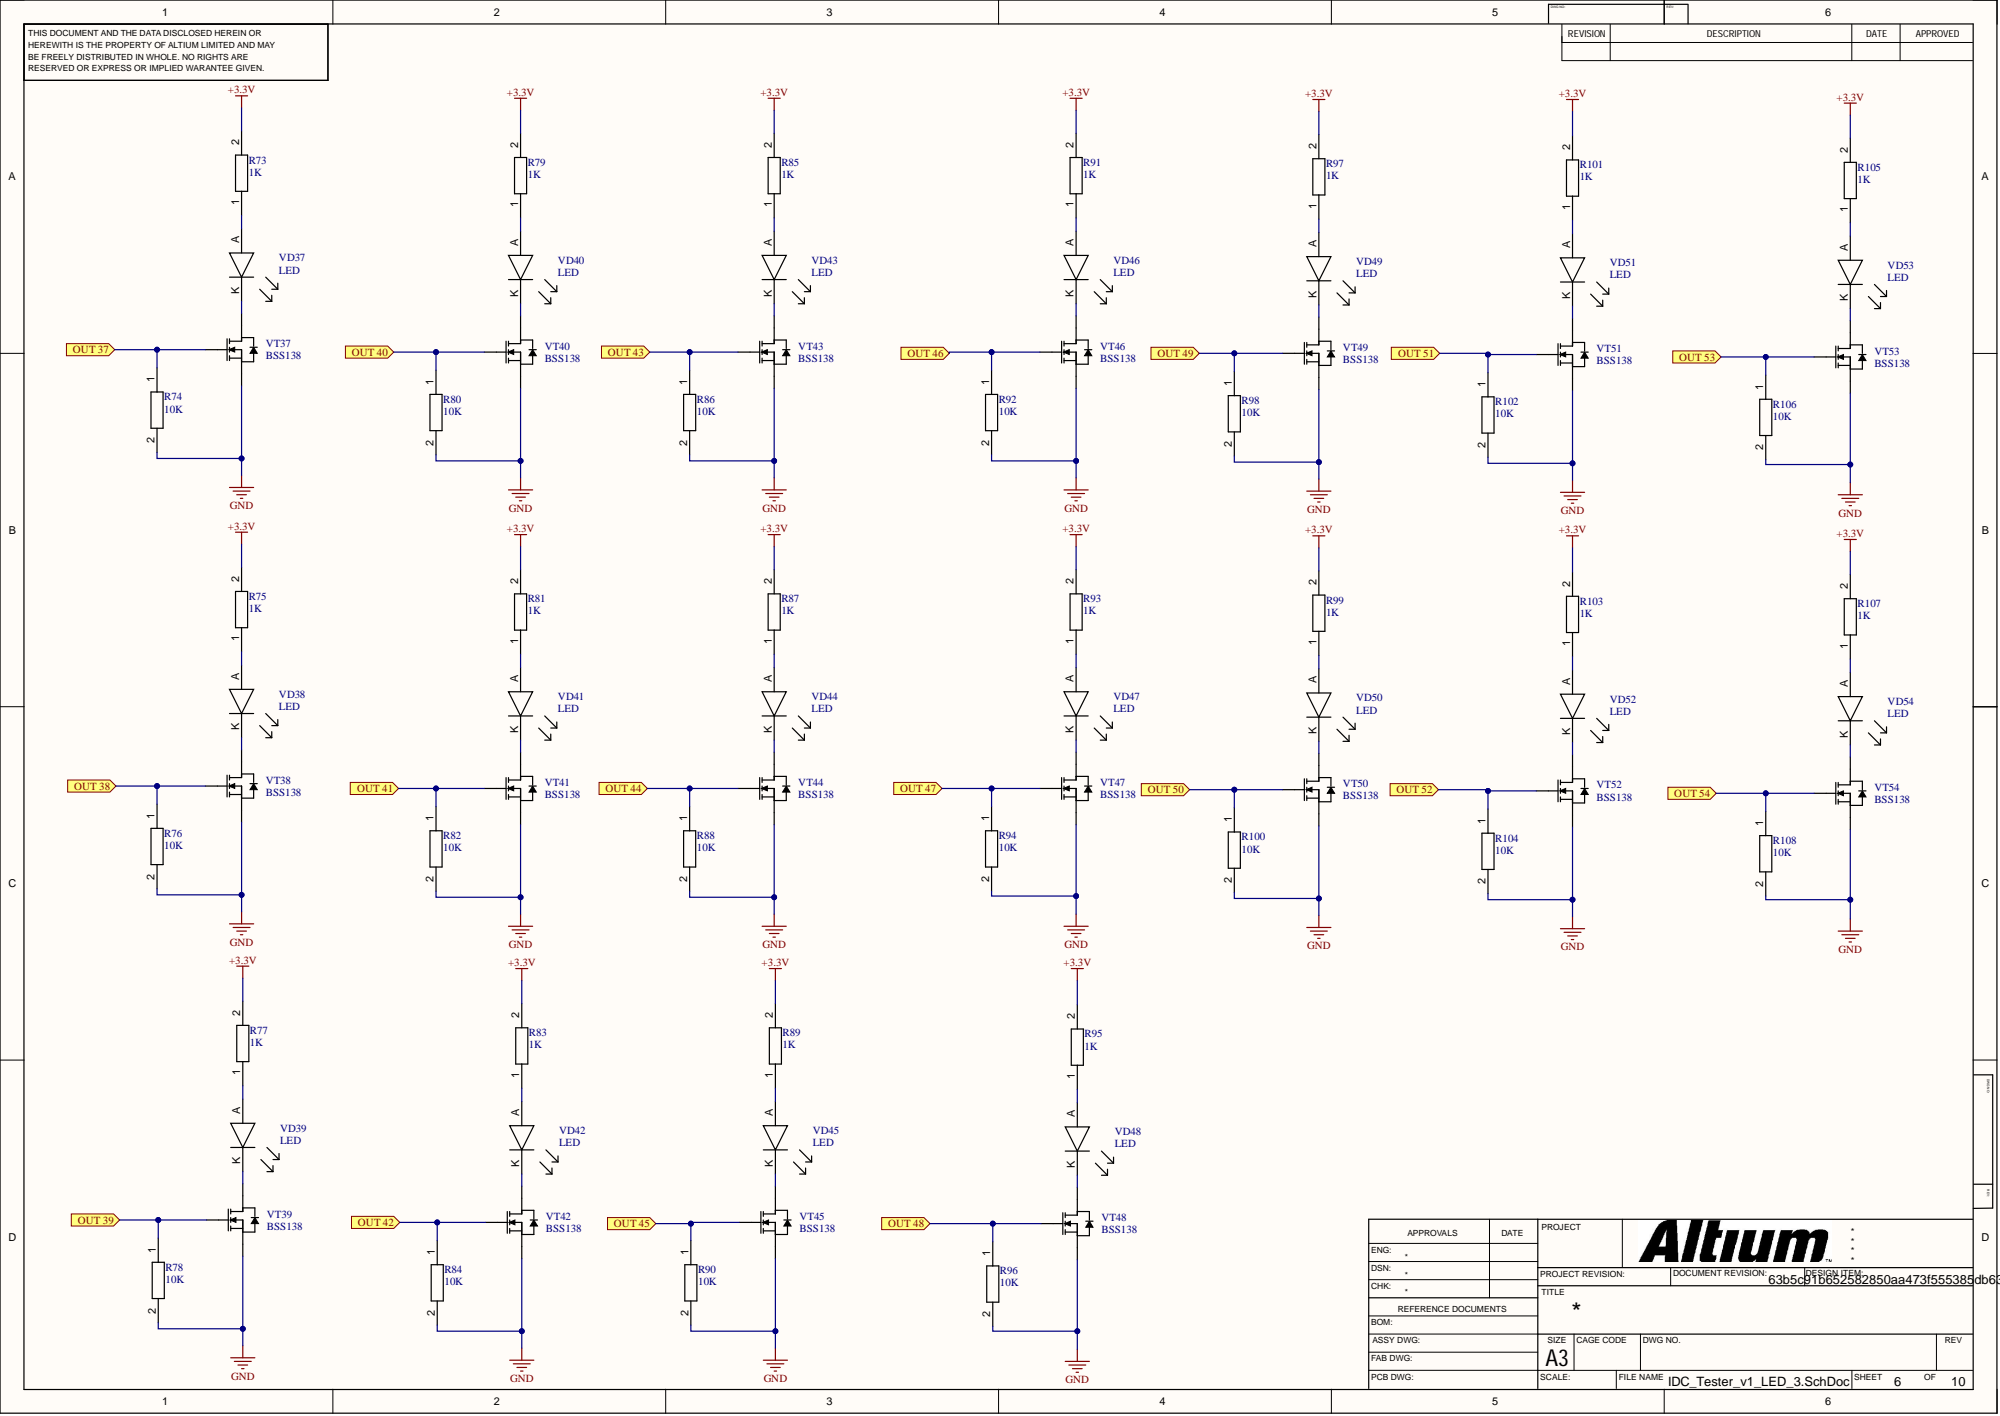
[picture p7: page 6]

DATE | PROJECT | * * APPROVALS * *

ENG: *

DSN: *

CHK:

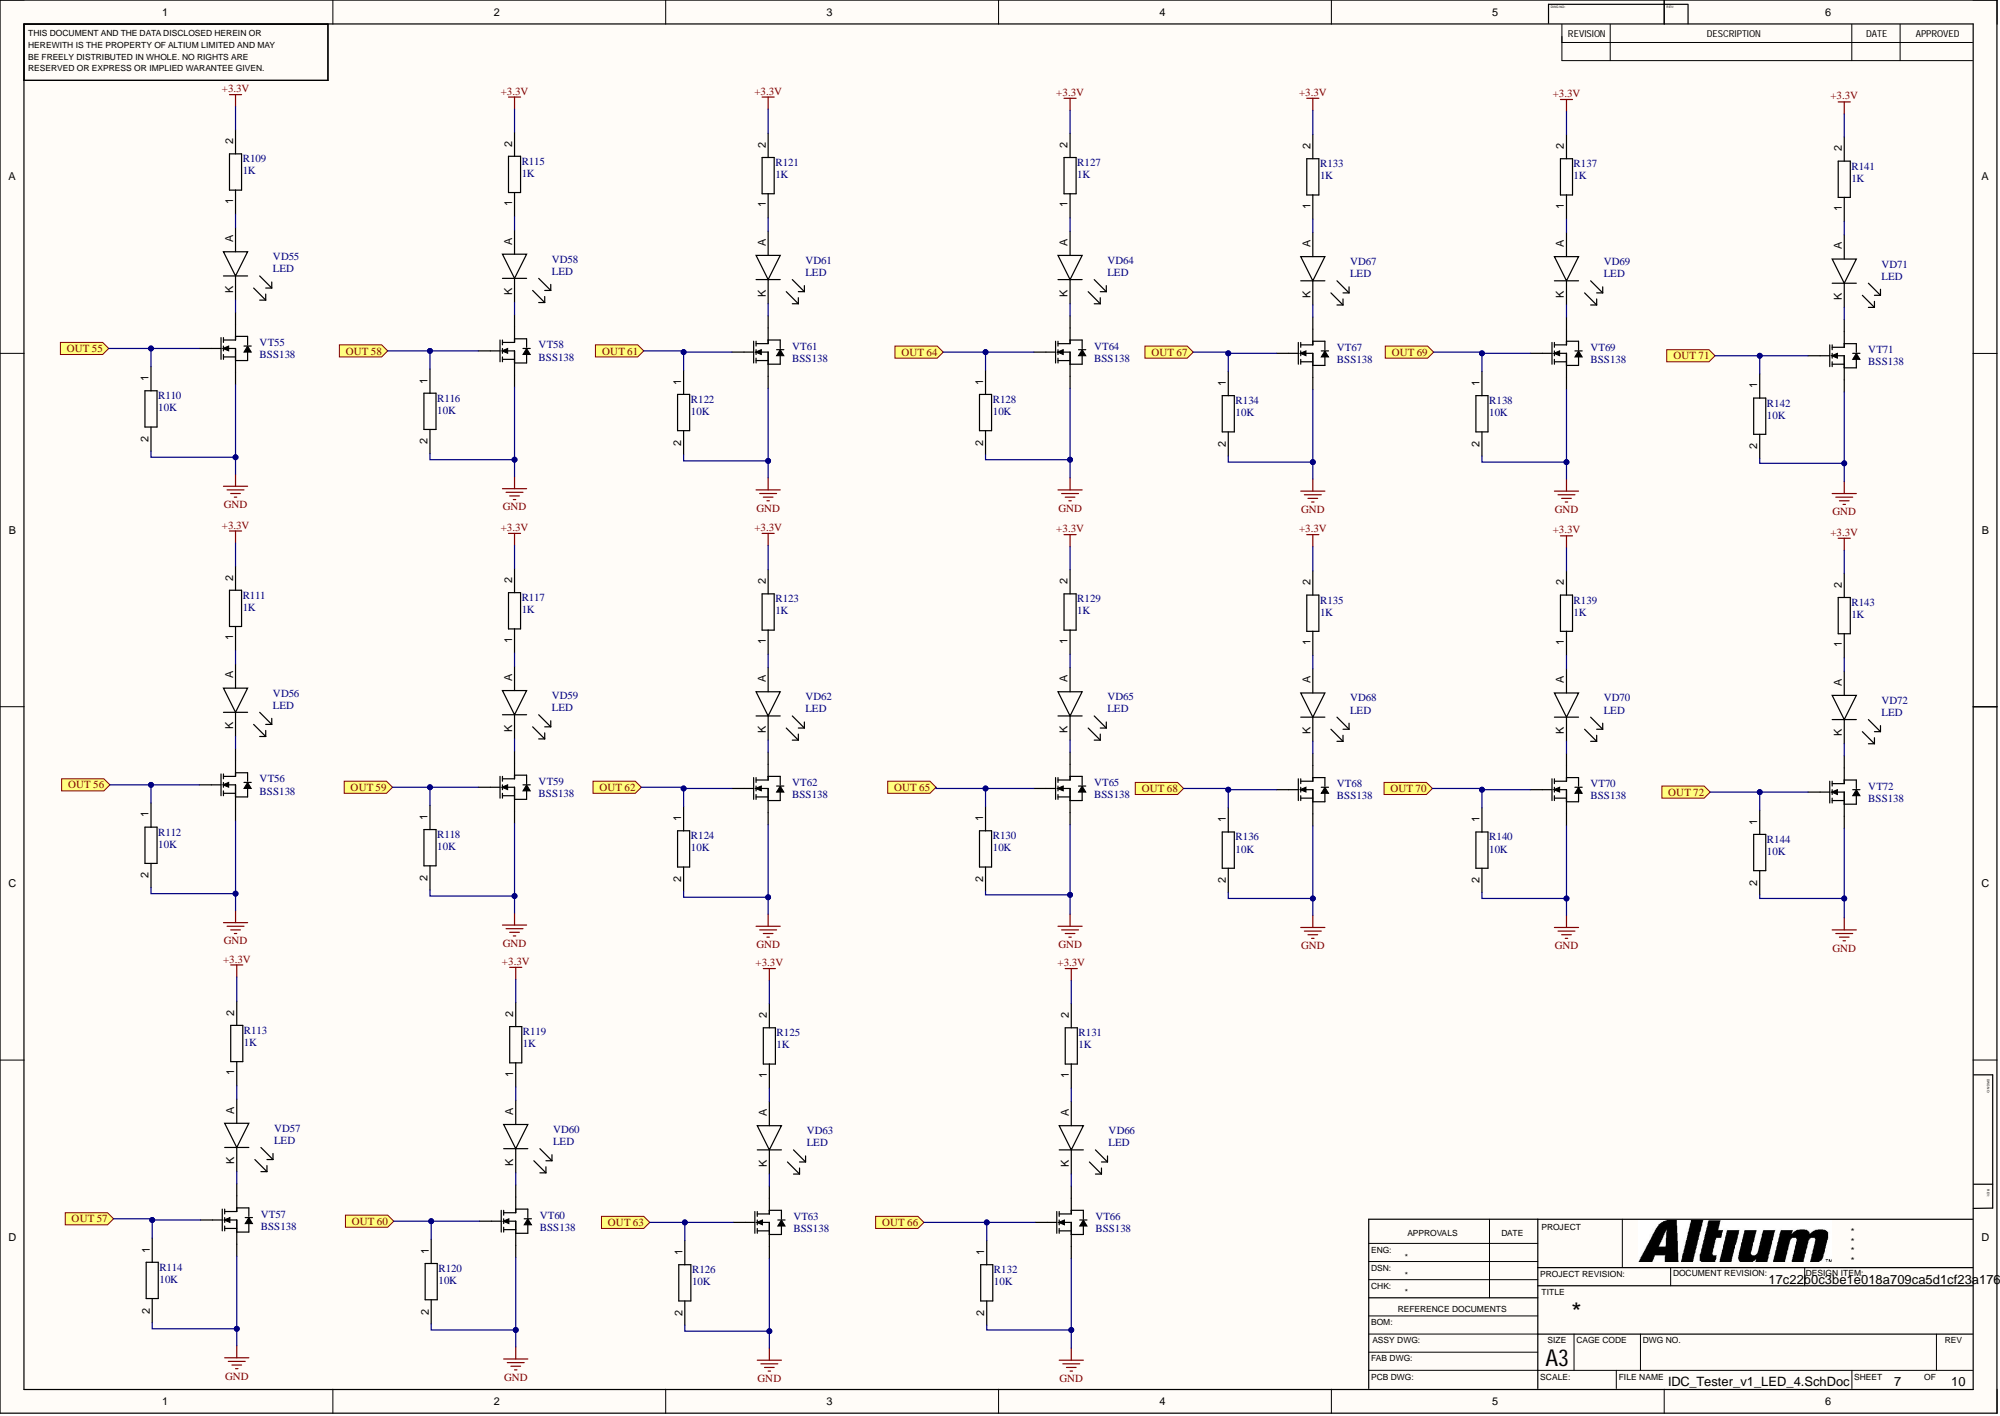
[picture p8: page 7]

DATE | PROJECT | * * APPROVALS * *

ENG: *

DSN: *

CHK:

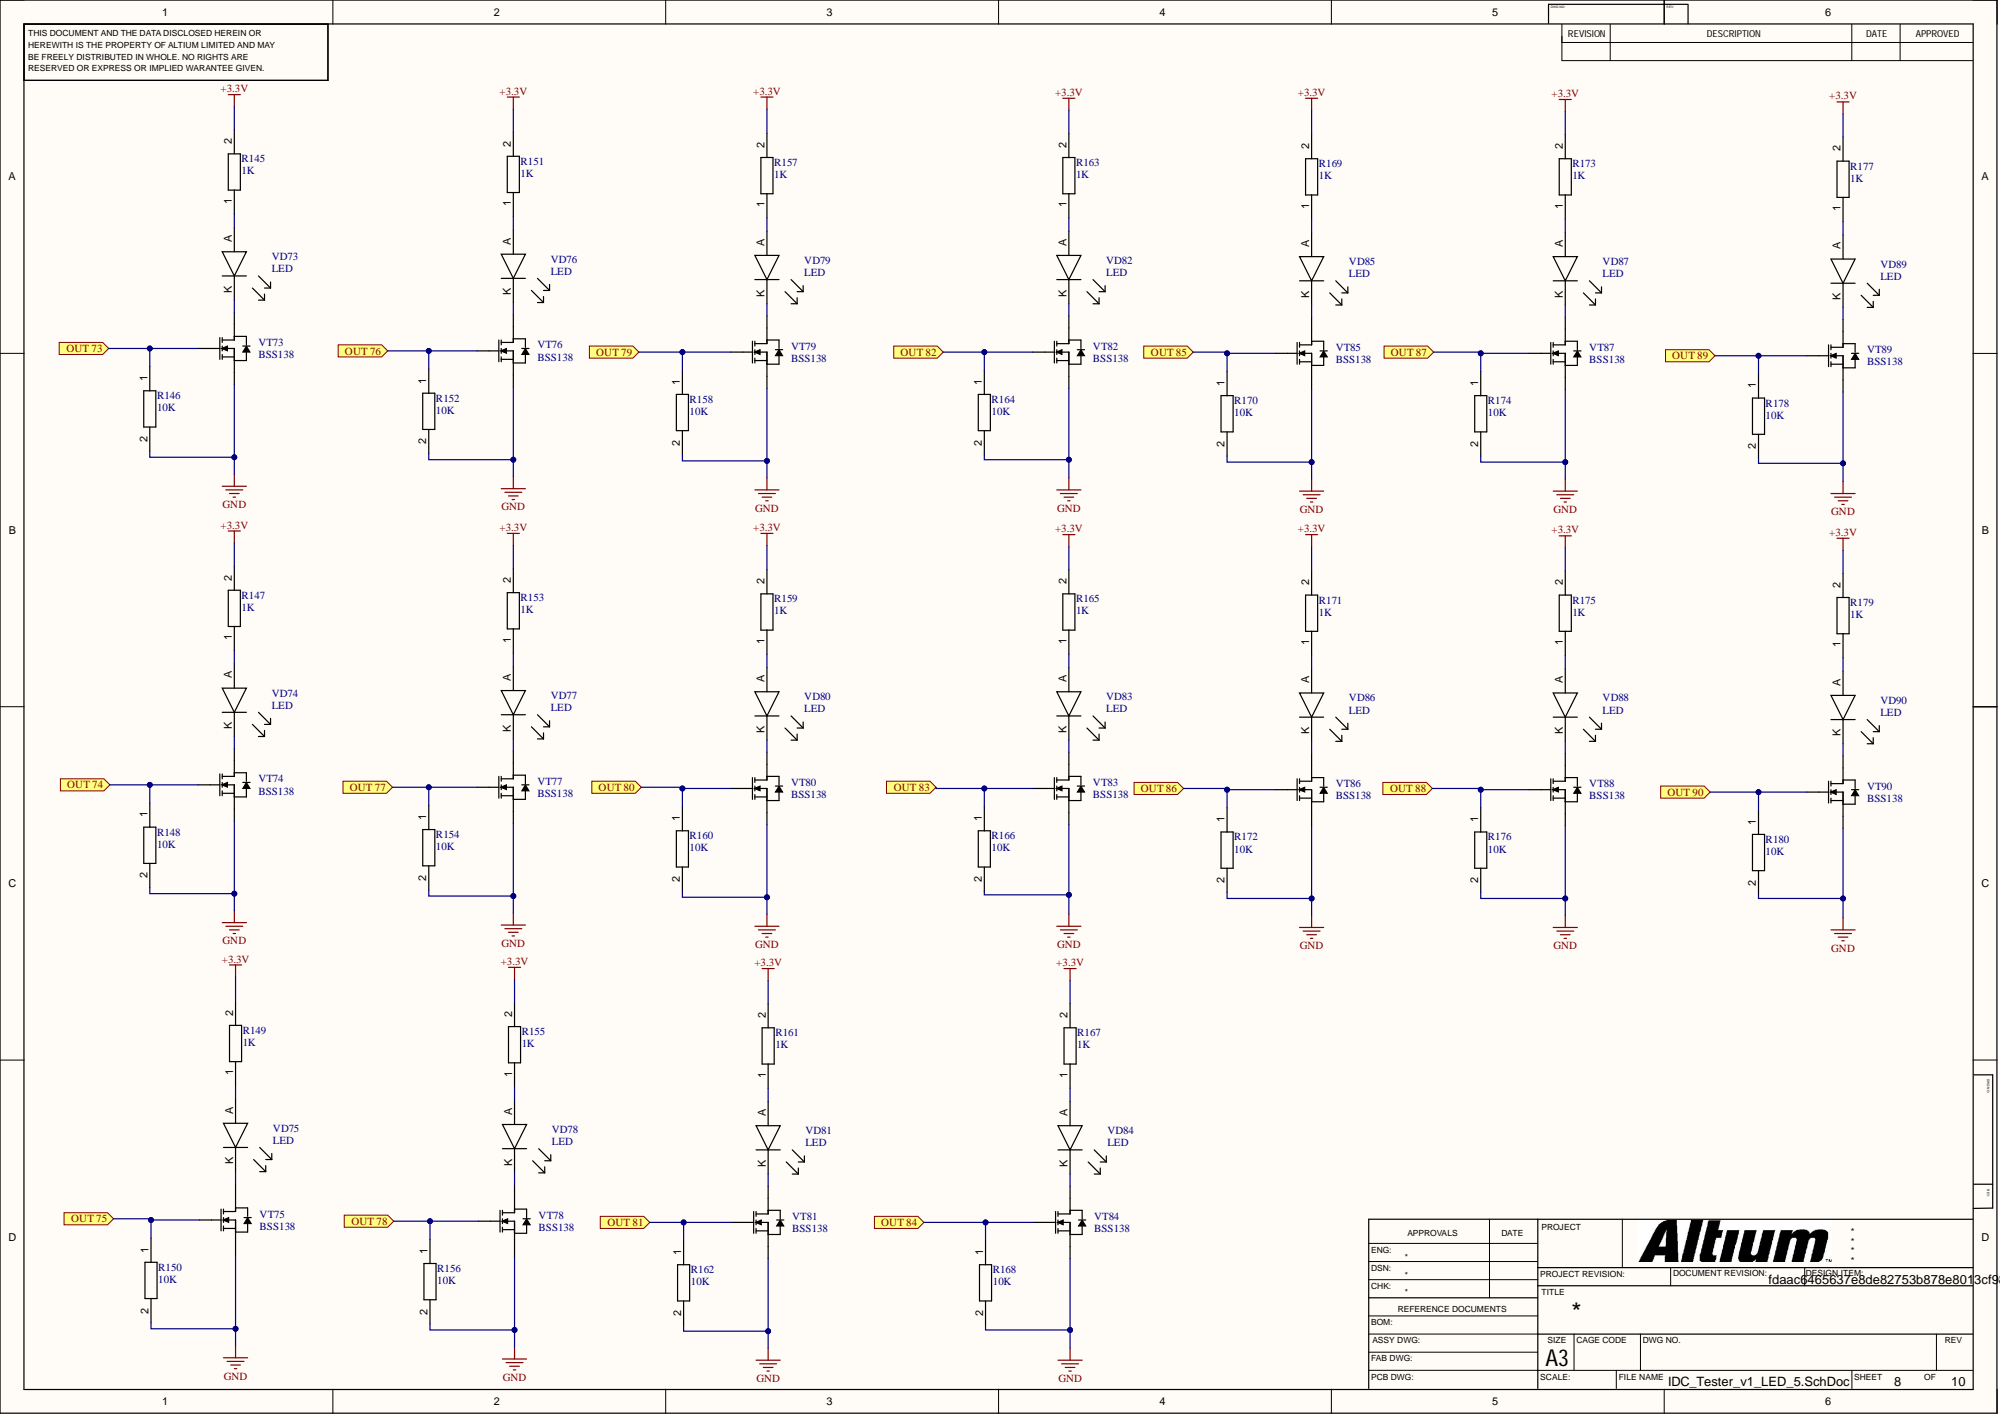
[picture p9: page 8]

DATE | PROJECT | * * APPROVALS * *

ENG: *

DSN: *

CHK:

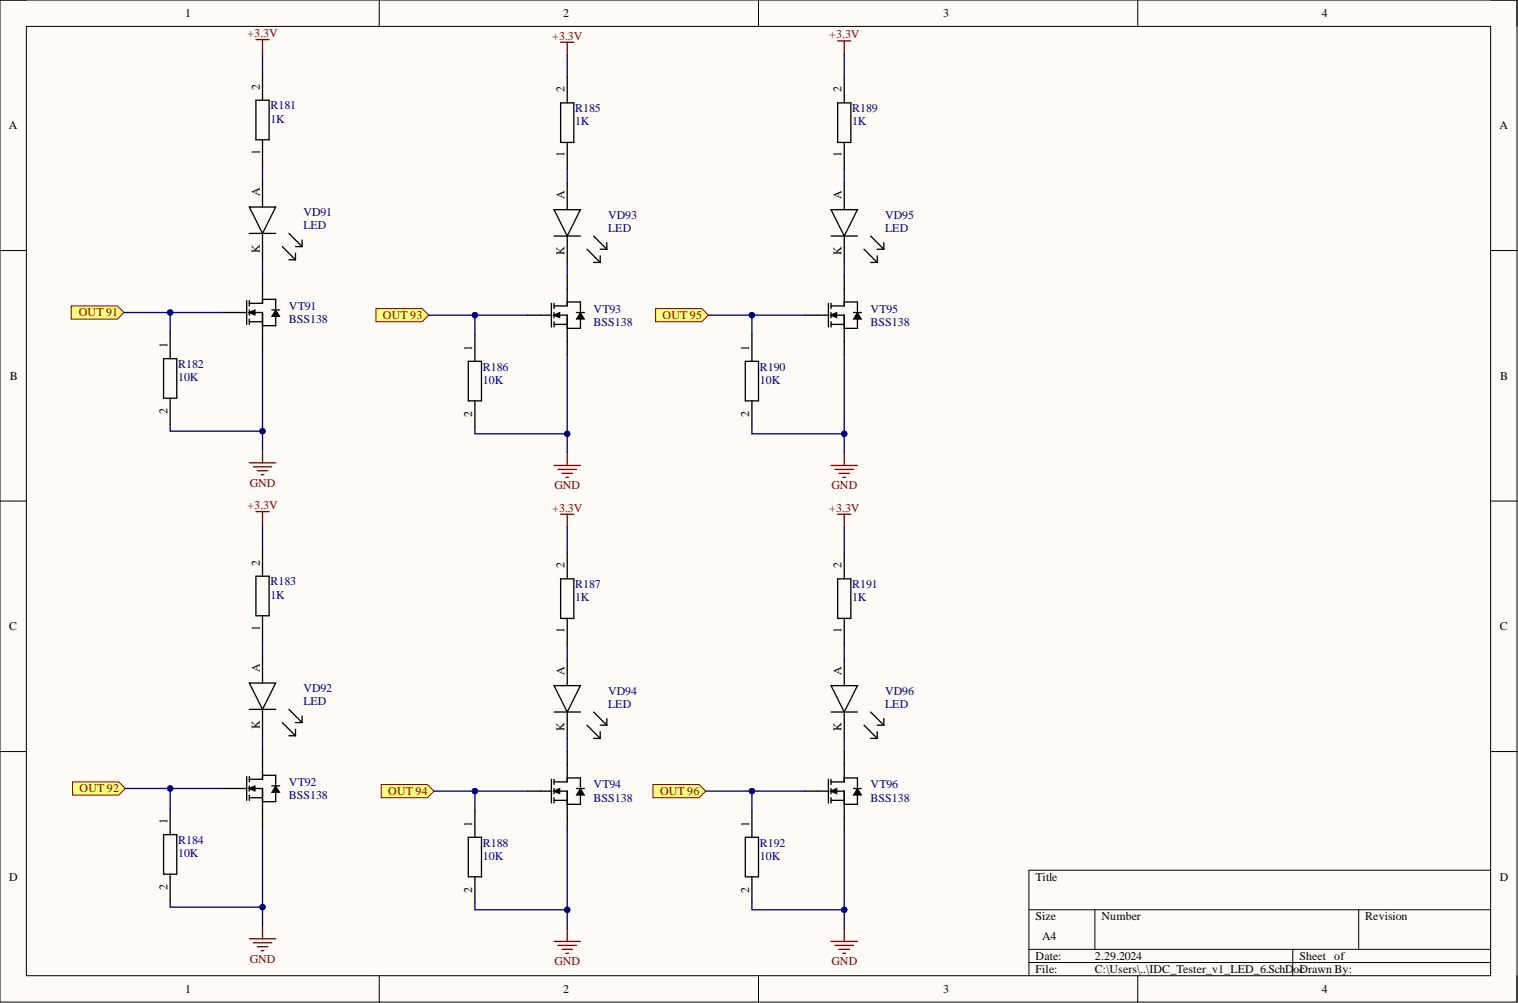
[picture p10: page 9]

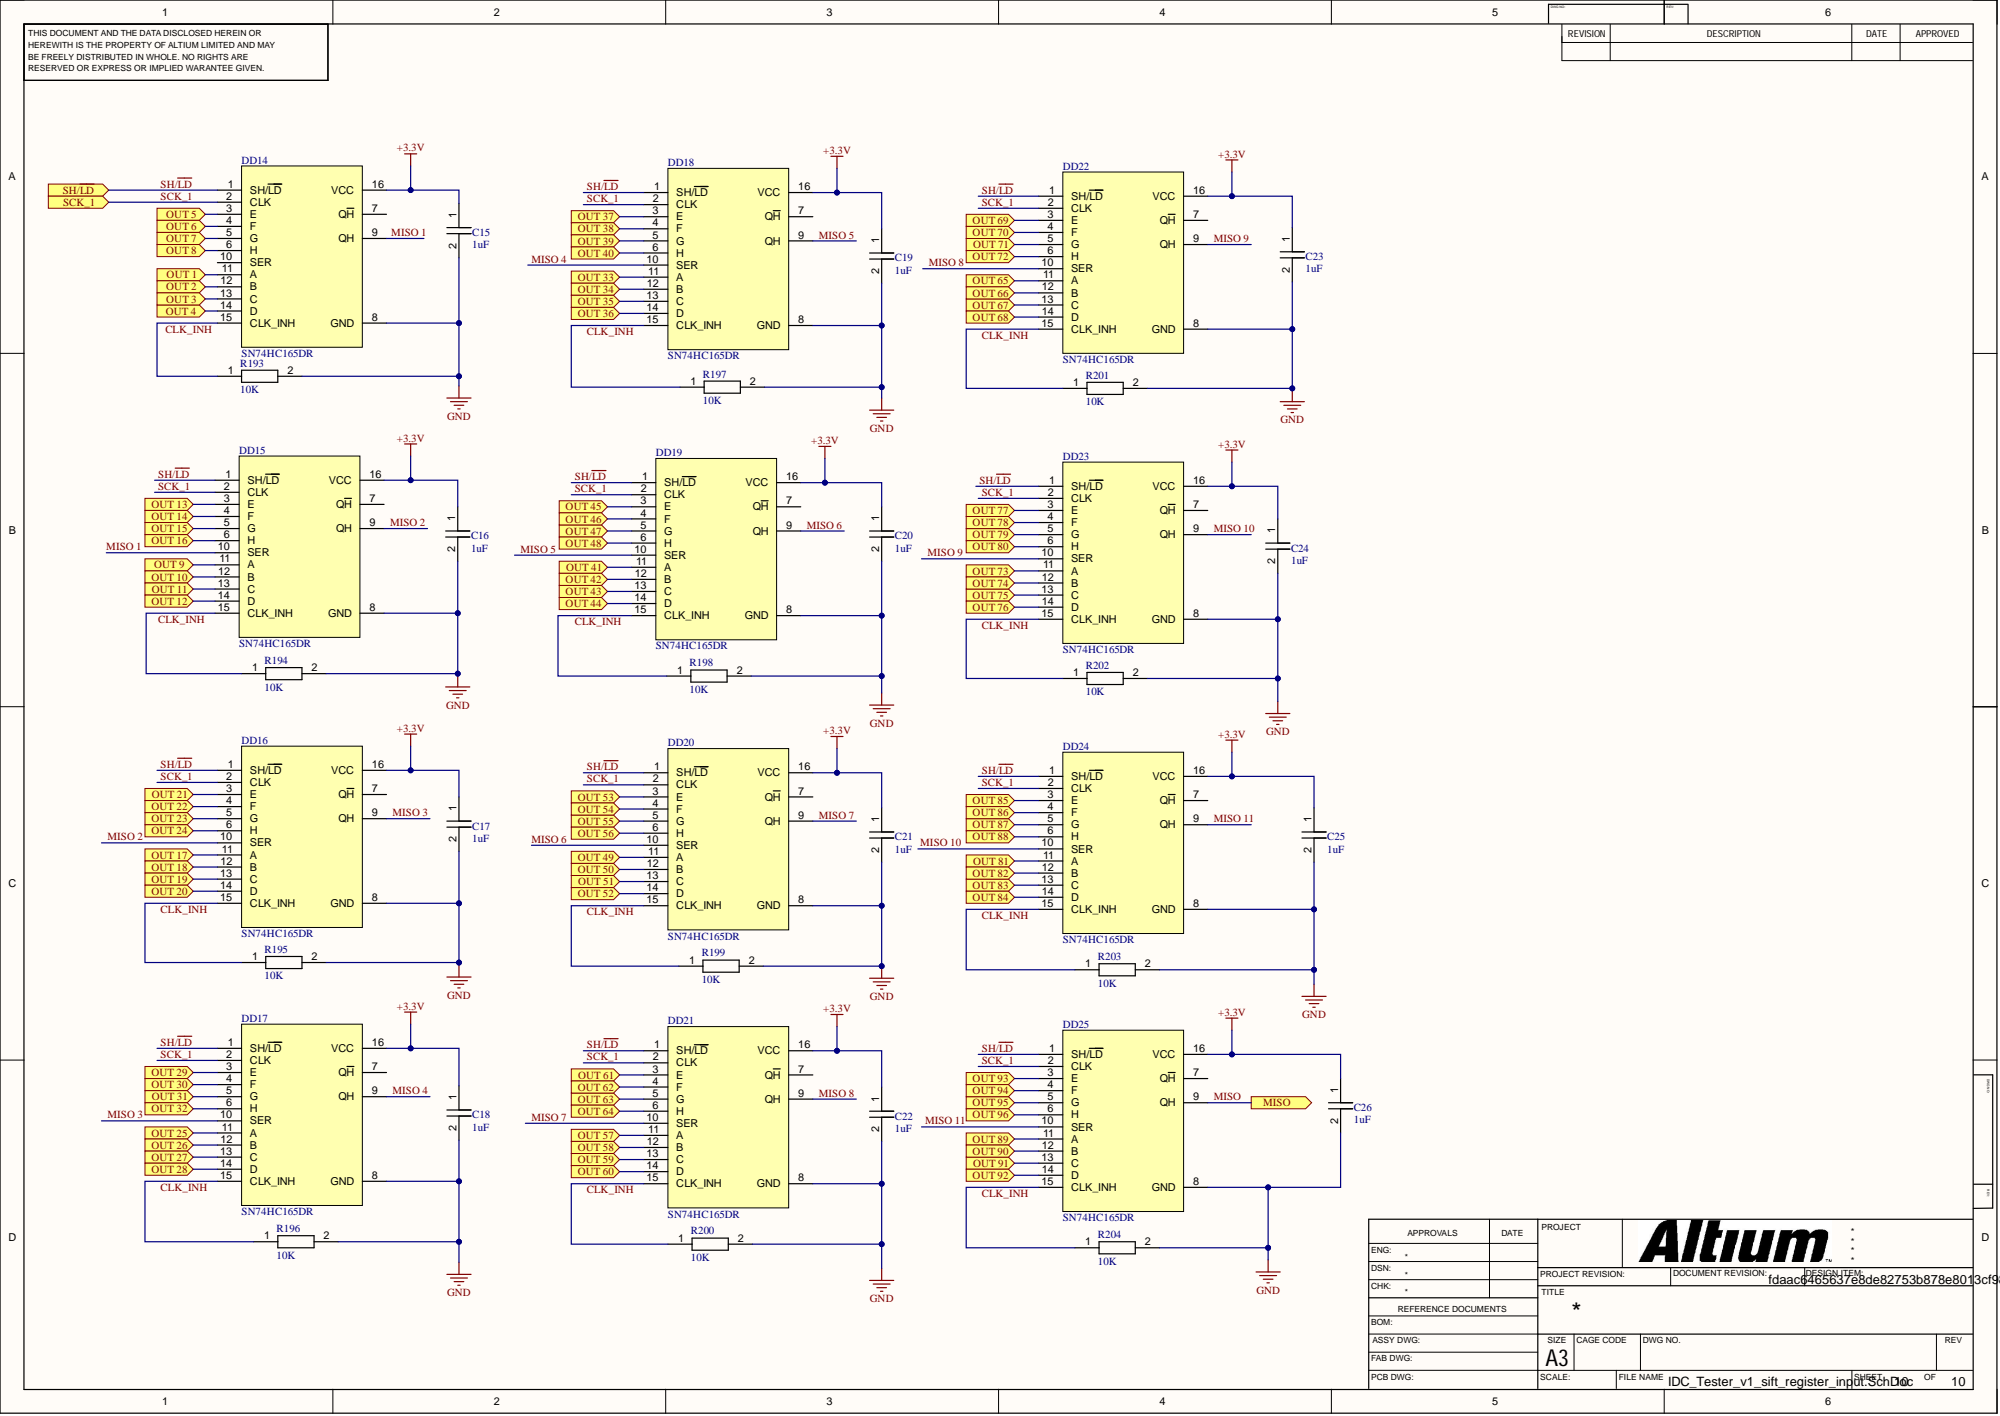
[picture p11: page 10]

DATE | PROJECT | * * APPROVALS * *

ENG: *
