Nikitosya13/Tesla-Tek-Altium/IDC_Tester_v1/_mount/IDC_Tester_v1_ASSEMBLY.PDF

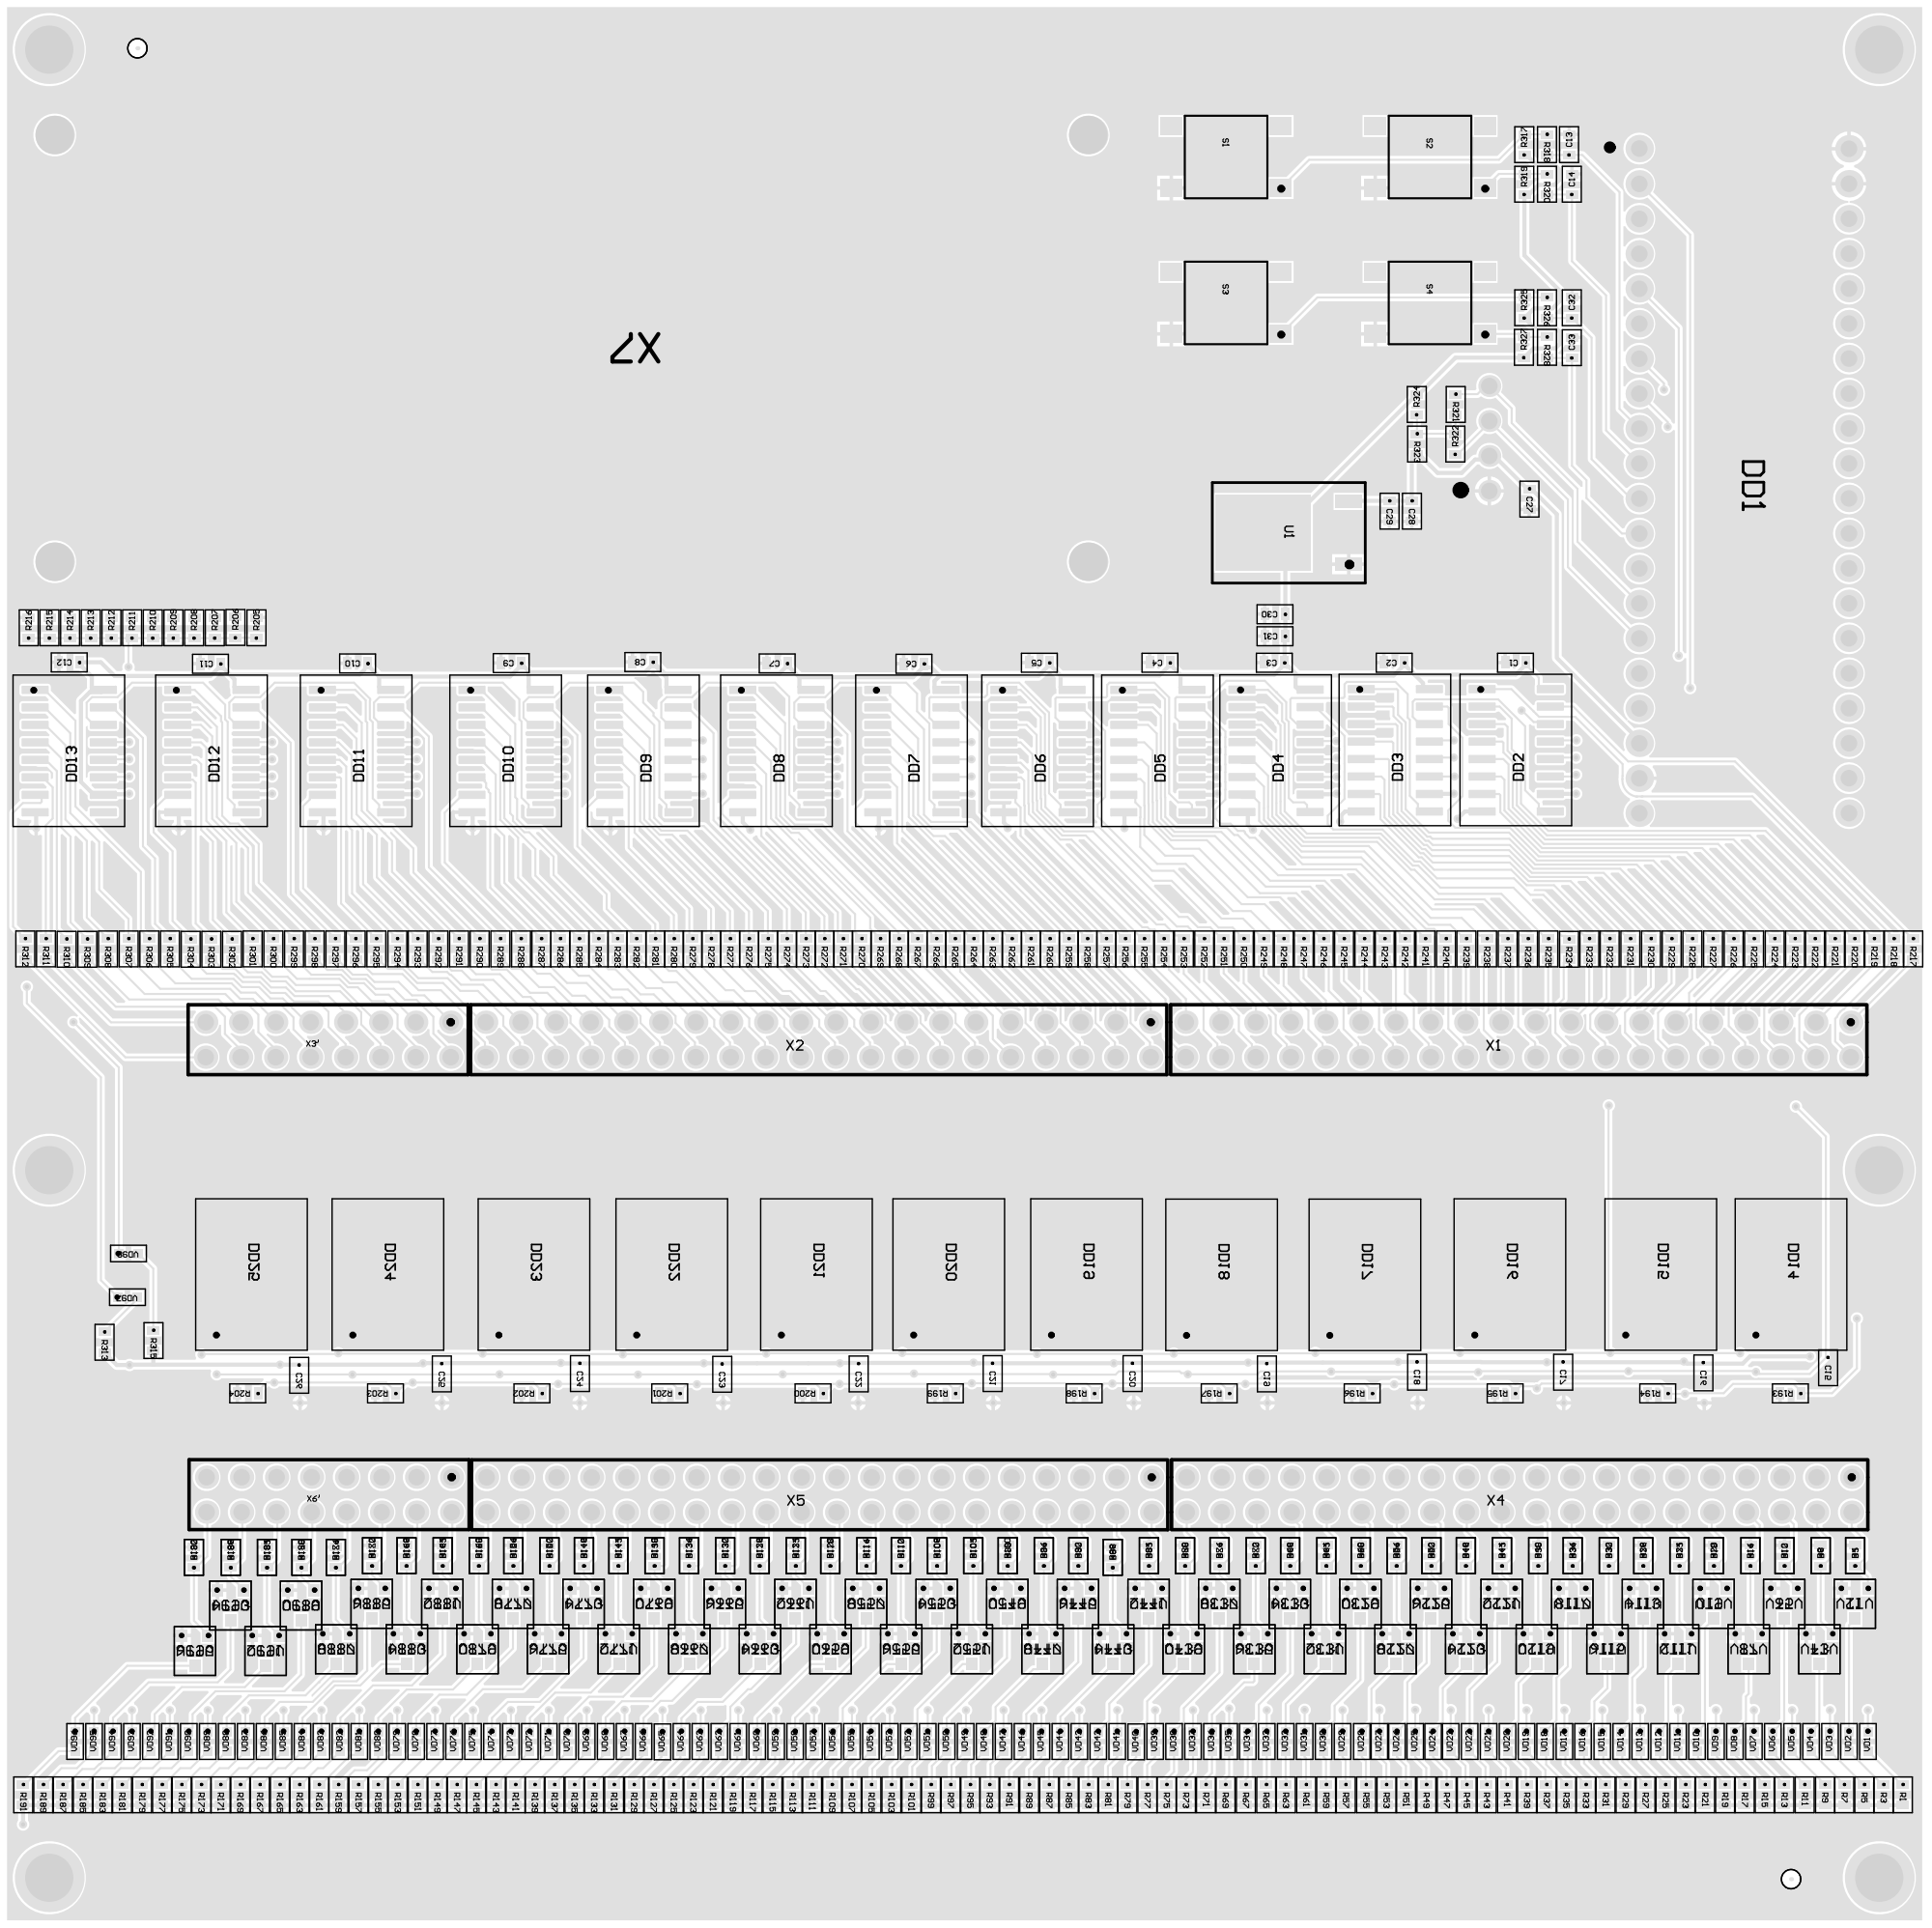
[picture p12: page 1]

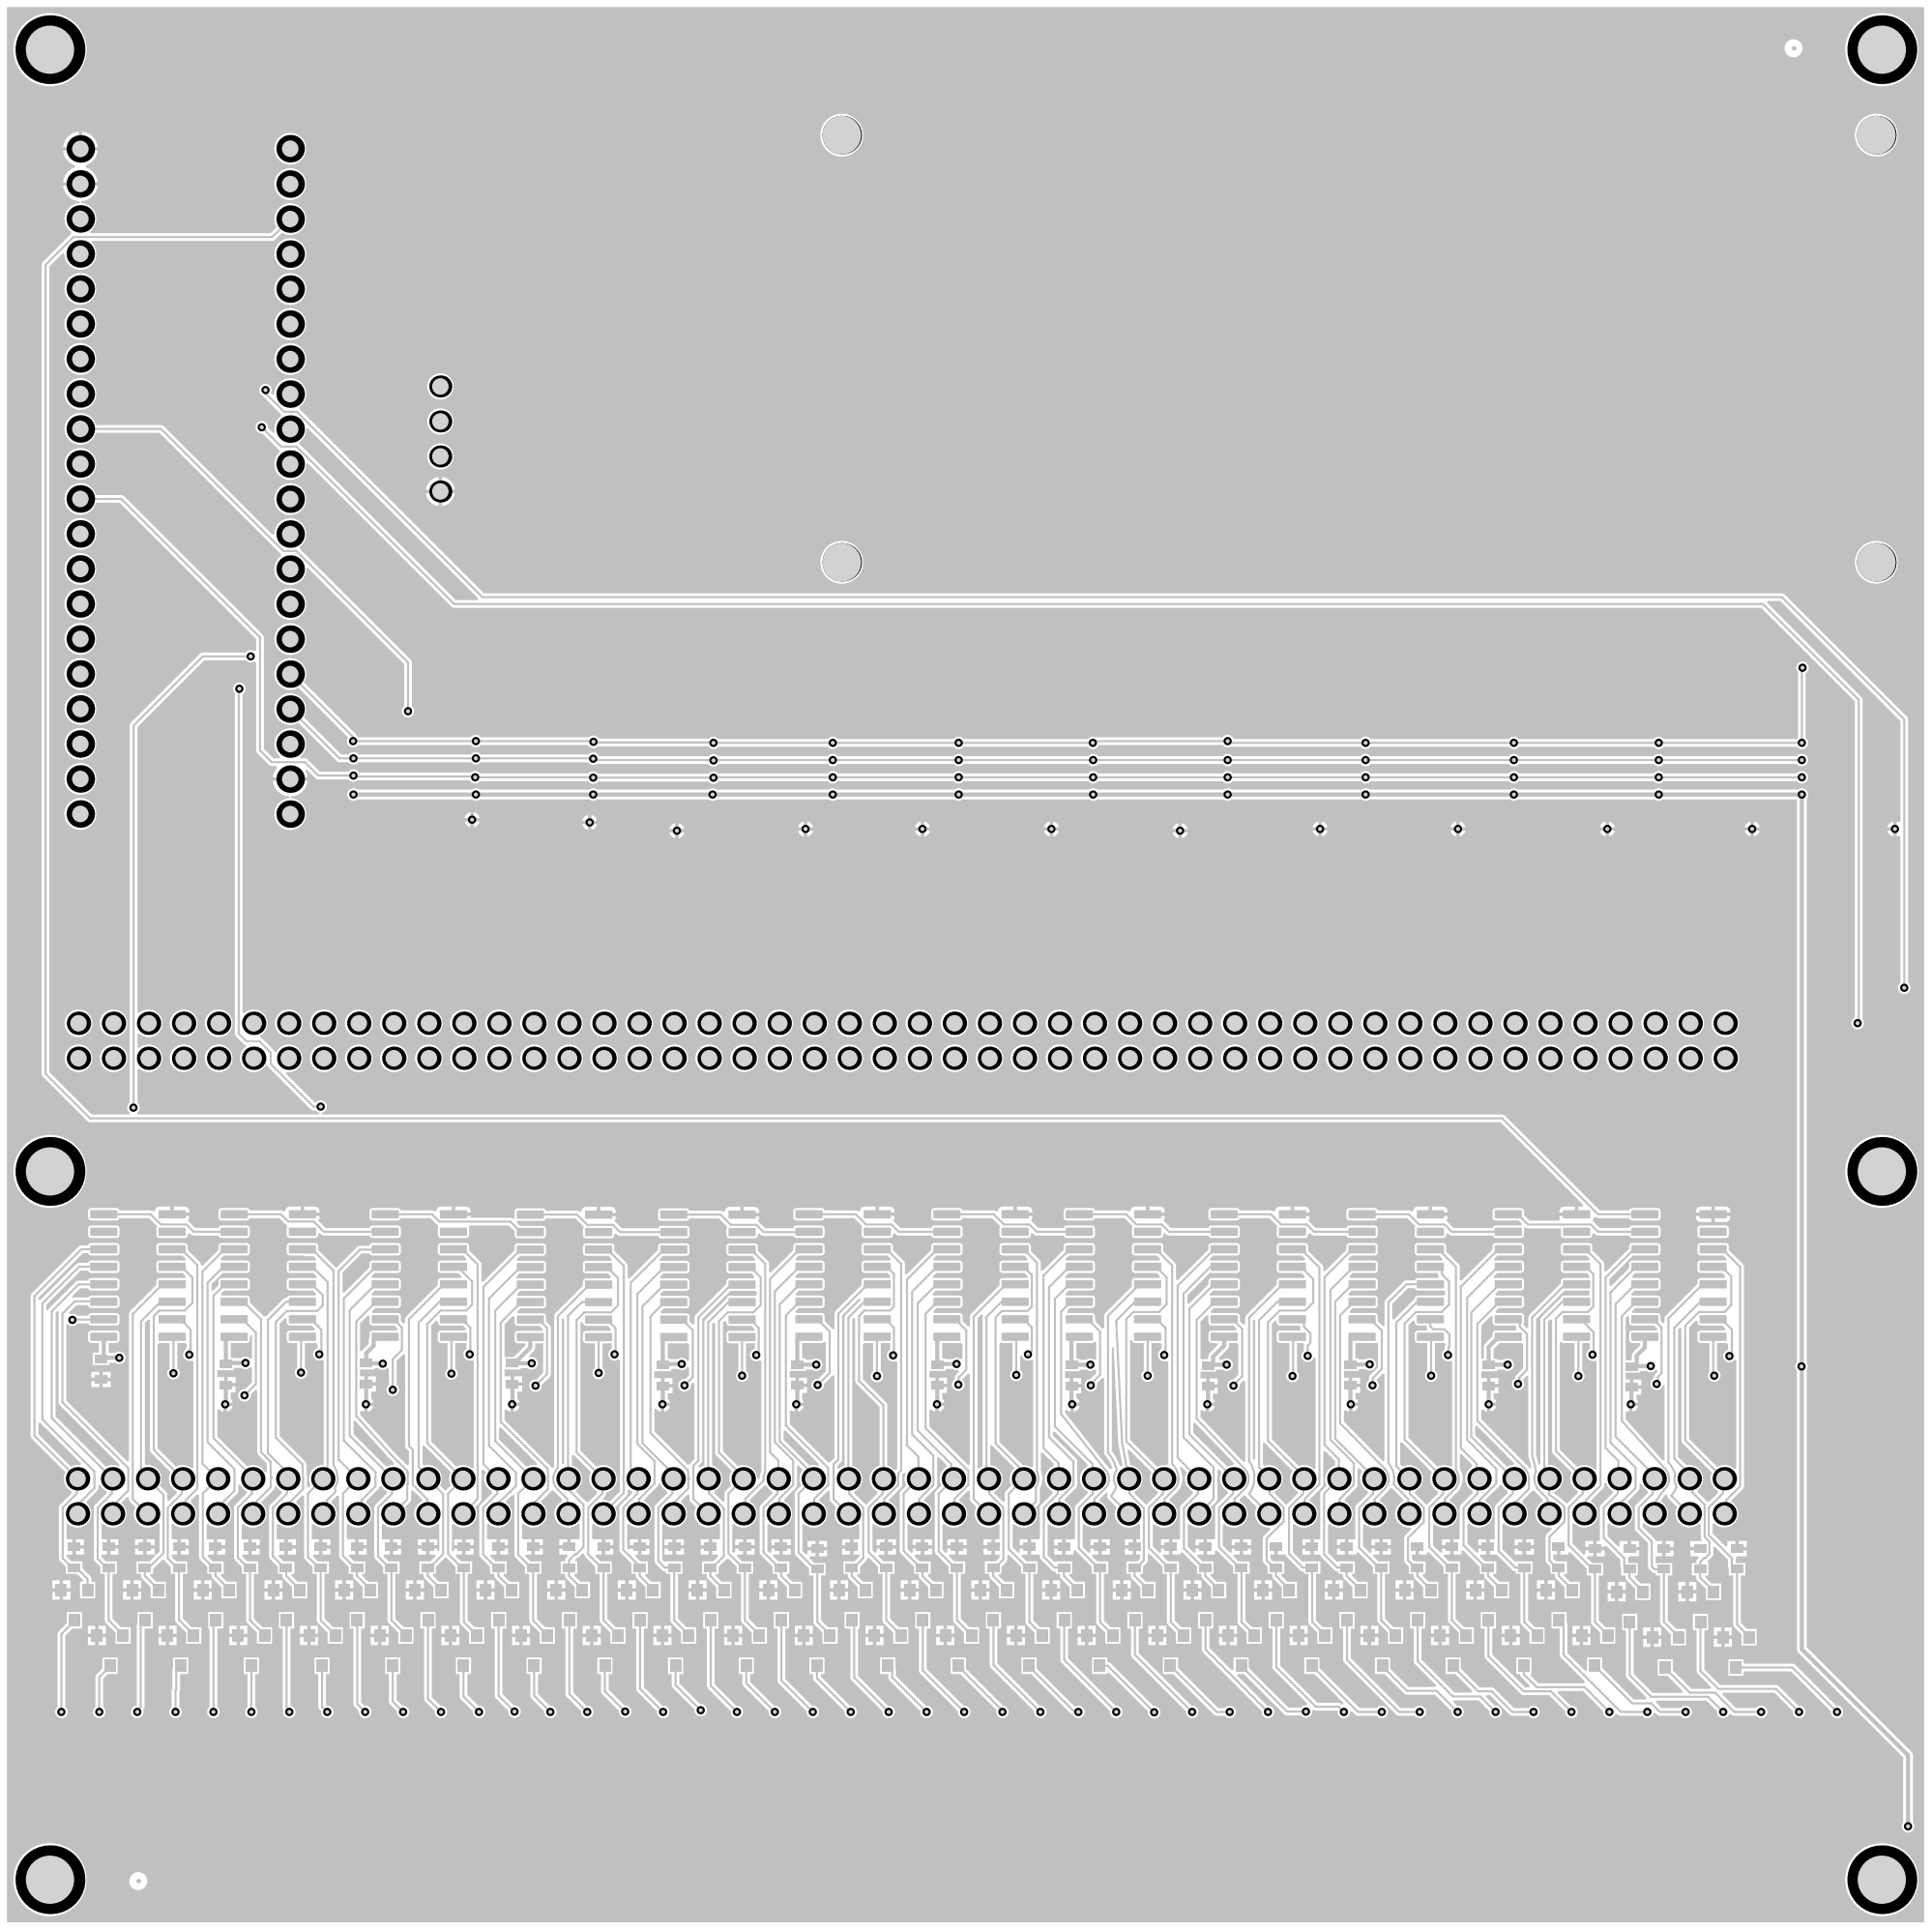
[picture p13: page 2]
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
