Nikitosya13/Tesla-Tek-Altium/(list of files, drawings)

Other design files:
IDC_Tester_v1/IDC_Tester_v1.PcbDoc
IDC_Tester_v1/IDC_Tester_v1.PrjPcb
IDC_Tester_v1/IDC_Tester_v1_connector.SchDoc
IDC_Tester_v1/IDC_Tester_v1_LED.SchDoc
IDC_Tester_v1/IDC_Tester_v1_LED_2.SchDoc
IDC_Tester_v1/IDC_Tester_v1_LED_3.SchDoc
IDC_Tester_v1/IDC_Tester_v1_LED_4.SchDoc
IDC_Tester_v1/IDC_Tester_v1_LED_5.SchDoc
IDC_Tester_v1/IDC_Tester_v1_LED_6.SchDoc
IDC_Tester_v1/IDC_Tester_v1_mcu.SchDoc
IDC_Tester_v1/IDC_Tester_v1_sift_register_input.SchDoc
IDC_Tester_v1/IDC_Tester_v1_sift_register_output.SchDoc
IDC_Tester_v1/PcbLib_IDC_Tester_v1.PcbLib
IDC_Tester_v1/Schlib_IDC_Tester_v1.SchLib
