Nikitosya13/Tesla-Tek-Altium/(commit log)

2024-02-08 Выполнено уго PLD-40
    [Schlib_IDC_Tester_v1.SchLib]
2024-02-08 Выполено УГО PLD-40
    [Schlib_IDC_Tester_v1.SchLib]
2024-02-08 Добавлен footprint и 3D модель элемента PLD-40
    [PcbLib_IDC_Tester_v1.PcbLib, Schlib_IDC_Tester_v1.SchLib]
2024-02-08 Добавлено: Уго компонента PLD-16 Footprint PLD-16 3D model
    [PcbLib_IDC_Tester_v1.PcbLib, Schlib_IDC_Tester_v1.SchLib]
2024-02-08 Добавлено УГО cветодиода, изменены посадочные места PLD-40 и PLD-16 с добавлением слоя mechanical 29 (нужно добавить обозначение первого пина)
    [PcbLib_IDC_Tester_v1.PcbLib, Schlib_IDC_Tester_v1.SchLib]
2024-02-12 test commit
    [PcbLib_IDC_Tester_v1.PcbLib]
2024-02-12 Добавлено Уго резистора
    [Schlib_IDC_Tester_v1.SchLib]
2024-02-12 Добавлен footprint для SMD резистора 0603
    [PcbLib_IDC_Tester_v1.PcbLib]
2024-02-12 Добавлено Уго и footprint для коннектора
    [PcbLib_IDC_Tester_v1.PcbLib, Schlib_IDC_Tester_v1.SchLib]
2024-02-12 Добавлен footprint светодиода (точкой обозначен на слое mechanical 29 катод)
    [PcbLib_IDC_Tester_v1.PcbLib, Schlib_IDC_Tester_v1.SchLib]
2024-02-12 Добавлено Уго и footprint сдвигового регистра SN74HC165DR
    [IDC_Tester_v1.PrjPcb, IDC_Tester_v1.SchDoc, PcbLib_IDC_Tester_v1.PcbLib, Schlib_IDC_Tester_v1.SchLib]
2024-02-13 Добавлено: параметры светодиода, Уго сдвигового регистра 74HC595
    [PcbLib_IDC_Tester_v1.PcbLib, Schlib_IDC_Tester_v1.SchLib]
2024-02-13 Ко всем элементам, за исключением stm-32 добавлены парметры
    [Schlib_IDC_Tester_v1.SchLib]
2024-02-13 Добавлены: параметры для транзистора, Уго для STM32 blue pill
    [Schlib_IDC_Tester_v1.SchLib]
2024-02-13 Добавлен footprint элемента stm32 blue pill
    [PcbLib_IDC_Tester_v1.PcbLib]
2024-02-13 Добавлены параметры STM32 blue pill
    [PcbLib_IDC_Tester_v1.PcbLib, Schlib_IDC_Tester_v1.SchLib]
2024-02-14 Добавлено Уго и footprint транзистора BSS138 из библиотеки Tesla-Tek
    [IDC_Tester_v1.SchDoc, PcbLib_IDC_Tester_v1.PcbLib, Schlib_IDC_Tester_v1.SchLib]
2024-02-14 Построение принципиальной схемы, выполнен первый лист, на котором расположены STM32, shift registr, connector
    [IDC_Tester_v1.PrjPcb, IDC_Tester_v1.SchDoc, IDC_Tester_v1_mcu-sift_register.SchDoc, Schlib_IDC_Tester_v1.SchLib]
2024-02-14 Добавлены порты к шифрт регистрам
    [IDC_Tester_v1_mcu-sift_register.SchDoc]
2024-02-14 Соеденины разъемы с помощью NET.wires
    [IDC_Tester_v1.PrjPcb, IDC_Tester_v1.SchDoc, IDC_Tester_v1_mcu-sift_register.SchDoc]
2024-02-14 Расставлены буквенные обозначения
    [IDC_Tester_v1.PrjPcb, IDC_Tester_v1.SchDoc, IDC_Tester_v1_connector_input.SchDoc, IDC_Tester_v1_mcu-sift_register.SchDoc]
2024-02-14 На втором листе схематик добавлены порты и разъемы PLD-40, PLD-16
    [IDC_Tester_v1_connector_input.SchDoc, IDC_Tester_v1_mcu-sift_register.SchDoc, Schlib_IDC_Tester_v1.SchLib]
2024-02-15 Добавлены выходные коннекторы на 2-ой лист схематик и подключены к ним порты "OUT"
    [IDC_Tester_v1_connector_input.SchDoc, Schlib_IDC_Tester_v1.SchLib]
2024-02-15 Добавлен новый лист схематик в проект (на котором будет выполнена схема подключения светодиодов)
    [IDC_Tester_v1.PrjPcb, IDC_Tester_v1_LED.SchDoc, IDC_Tester_v1_connector.SchDoc, IDC_Tester_v1_connector_input.SchDoc]
2024-02-15 На лист LED (схематик) была добавлена схема развязки подключения светодиодов (18 шт.)
    [IDC_Tester_v1_LED.SchDoc, IDC_Tester_v1_connector.SchDoc, IDC_Tester_v1_mcu-sift_register.SchDoc, Schlib_IDC_Tester_v1.SchLib]
2024-02-15 Добавлен второй лист с разводкой светодиодов LED_2
    [IDC_Tester_v1.PrjPcb, IDC_Tester_v1_LED.SchDoc, IDC_Tester_v1_LED_2.SchDoc, IDC_Tester_v1_connector.SchDoc]
2024-02-15 Добавлен 3 лист схематик с разводкой светодиодов (LED_3)
    [IDC_Tester_v1.PrjPcb, IDC_Tester_v1_LED_2.SchDoc, IDC_Tester_v1_LED_3.SchDoc]
2024-02-15 Добавлен 4 лист схематик с разводкой схемы подключения светодиодов LED_4
    [IDC_Tester_v1.PrjPcb, IDC_Tester_v1_LED_4.SchDoc]
2024-02-15 Добавлен 5 лист (схематик) с разводкой схемы подключения светодиодов LED_5
    [IDC_Tester_v1.PrjPcb, IDC_Tester_v1_LED_5.SchDoc]
2024-02-15 Добавлен 6 лист (схематик) с разводкой схемы подключения светодиодов LED_6
    [IDC_Tester_v1.PrjPcb, IDC_Tester_v1_LED_5.SchDoc, IDC_Tester_v1_LED_6.SchDoc]
2024-02-15 Добавлен лист схематик с выходными сдвиговыми регистрами
    [IDC_Tester_v1.PrjPcb, IDC_Tester_v1_mcu-sift_register.SchDoc, IDC_Tester_v1_mcu-sift_register_output.SchDoc, IDC_Tester_v1_sift_register_input.SchDoc]
2024-02-15 Добавлены порты к входным сдвиговым регистрам
    [IDC_Tester_v1_sift_register_input.SchDoc]
2024-02-15 Внесены правки в обозначения power port
    [IDC_Tester_v1.PrjPcb, IDC_Tester_v1_connector.SchDoc, IDC_Tester_v1_mcu-sift_register_output.SchDoc, IDC_Tester_v1_sift_register_input.SchDoc, Schlib_IDC_Tester_v1.SchLib]
2024-02-16 Убраны ошибки связанные с off grid
    [IDC_Tester_v1.PrjPcb, IDC_Tester_v1_LED.SchDoc, IDC_Tester_v1_LED_2.SchDoc, IDC_Tester_v1_LED_3.SchDoc, IDC_Tester_v1_LED_4.SchDoc, IDC_Tester_v1_LED_5.SchDoc, IDC_Tester_v1_LED_6.SchDoc, IDC_Tester_v1_connector.SchDoc]
2024-02-16 Добавлено УГО конденсатора
    [IDC_Tester_v1.PrjPcb, IDC_Tester_v1_LED.SchDoc, IDC_Tester_v1_LED_2.SchDoc, IDC_Tester_v1_LED_3.SchDoc, IDC_Tester_v1_LED_4.SchDoc, IDC_Tester_v1_LED_5.SchDoc, IDC_Tester_v1_LED_6.SchDoc, IDC_Tester_v1_connector.SchDoc]
2024-02-16 Добавлены развязывающие конденсаторы на схему
    [IDC_Tester_v1_mcu-sift_register_output.SchDoc, PcbLib_IDC_Tester_v1.PcbLib, Schlib_IDC_Tester_v1.SchLib]
2024-02-18 Изменено Уго сдвиговых регистров
    [IDC_Tester_v1.PrjPcb, IDC_Tester_v1_mcu-sift_register_output.SchDoc, IDC_Tester_v1_sift_register_input.SchDoc, Schlib_IDC_Tester_v1.SchLib]
2024-02-18 Добалвены резисторы и управляющий вывод с мк на сдвиговый регистр 74HC595
    [IDC_Tester_v1.PrjPcb, IDC_Tester_v1_mcu-sift_register_output.SchDoc, Schlib_IDC_Tester_v1.SchLib]
2024-02-19 Добавлен в библиотеку компонент Resistor 10R
    [IDC_Tester_v1_LED_3.SchDoc, PcbLib_IDC_Tester_v1.PcbLib, Schlib_IDC_Tester_v1.SchLib]
2024-02-19 Добавлены токоограничительные резисторы на сдвиговые регистры 74HC595, а также STM32 перенесена на отдельный схематик лист для удобства работы
    [IDC_Tester_v1.PrjPcb, IDC_Tester_v1_connector.SchDoc, IDC_Tester_v1_mcu-sift_register_output.SchDoc, IDC_Tester_v1_mcu.SchDoc, IDC_Tester_v1_sift_register_output.SchDoc, Schlib_IDC_Tester_v1.SchLib]
2024-02-19 Добавлено уго и footprint кнопки (button)
    [IDC_Tester_v1_mcu.SchDoc, PcbLib_IDC_Tester_v1.PcbLib, Schlib_IDC_Tester_v1.SchLib]
2024-02-19 Добавлены схемы подключения кнопок для мк STM32, а также развязочные конденсаторы на входные сдвиговые регистры 74HC165
    [IDC_Tester_v1_mcu.SchDoc, IDC_Tester_v1_sift_register_input.SchDoc]
2024-02-19 Добавлено УГО и footprint LCD1602
    [PcbLib_IDC_Tester_v1.PcbLib, Schlib_IDC_Tester_v1.SchLib]
2024-02-20 Добавлен на лист схематик LCD1602, подведены подтягивающие резисторы к питанию
    [IDC_Tester_v1_mcu.SchDoc, PcbLib_IDC_Tester_v1.PcbLib, Schlib_IDC_Tester_v1.SchLib]
2024-02-20 Добавлен развязывающий конденсатор на LCD
    [IDC_Tester_v1_mcu.SchDoc]
2024-02-20 Добавлены параметры в УГО PLD-16 (out) и PLD-40 (out)
    [IDC_Tester_v1.PrjPcb, IDC_Tester_v1_connector.SchDoc, IDC_Tester_v1_mcu.SchDoc, Schlib_IDC_Tester_v1.SchLib]
2024-02-20 Коннектор питания +3.3В заменен на преобразователь, подключенный к STM 32
    [IDC_Tester_v1_mcu.SchDoc, PcbLib_IDC_Tester_v1.PcbLib, Schlib_IDC_Tester_v1.SchLib]
2024-02-22 Элементы принципиальной схемы перенесены на PCB лист и расставлены на плату, заданы правила трассировки
    [IDC_Tester_v1.PcbDoc, IDC_Tester_v1.PrjPcb, IDC_Tester_v1_LED.SchDoc, IDC_Tester_v1_LED_2.SchDoc, IDC_Tester_v1_LED_5.SchDoc, IDC_Tester_v1_connector.SchDoc, IDC_Tester_v1_mcu.SchDoc, IDC_Tester_v1_sift_register_input.SchDoc]
2024-02-24 Выполенена трасировка печатной платы
    [IDC_Tester_v1.PcbDoc, IDC_Tester_v1_mcu.SchDoc, IDC_Tester_v1_sift_register_output.SchDoc]
2024-02-27 Внесены правки по трассировки (нужно доделать светодиоды и просмотреть расстоняия между линиями, по возможности расширить)
    [IDC_Tester_v1.PcbDoc, IDC_Tester_v1_connector.SchDoc, IDC_Tester_v1_mcu.SchDoc, IDC_Tester_v1_sift_register_output.SchDoc, PcbLib_IDC_Tester_v1.PcbLib, Schlib_IDC_Tester_v1.SchLib]
2024-02-28 Плата с исправленными замечаниями и расставленными дезигнаторами
    [IDC_Tester_v1.PcbDoc, IDC_Tester_v1.PrjPcb, IDC_Tester_v1_mcu.SchDoc, PcbLib_IDC_Tester_v1.PcbLib]
2024-02-28 Исправлено расстояние между разъемами PLD-40 и PLD-16
    [IDC_Tester_v1.PcbDoc]
2024-02-29 Добавлена выходная конструкторская документация проекта
    [Bill of Materials-IDC_Tester_v1.xlsx, IDC_Tester_v1.PcbDoc, IDC_Tester_v1.PrjPcb, IDC_Tester_v1.step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]
